ryanjhermes/Wearable/enclosure/generated/mechanical_review/pcb_front.png

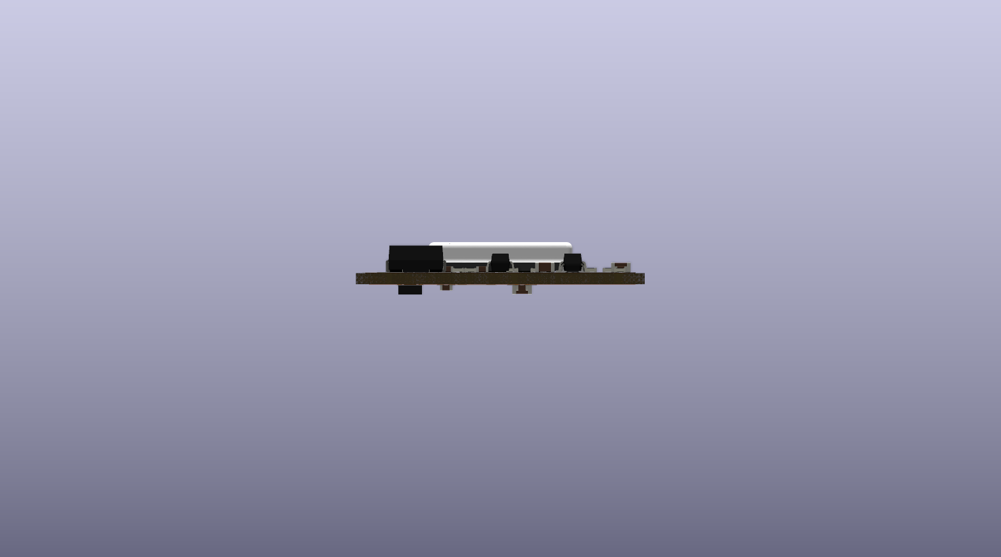
enclosure/generated/mechanical_review/pcb_front.png
