ryanjhermes/Wearable/enclosure/generated/mechanical_review/pcb_bottom.png

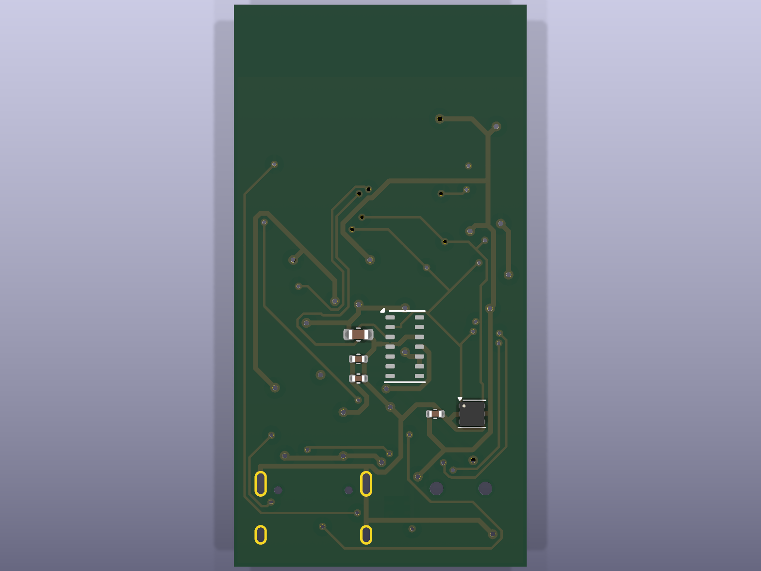
enclosure/generated/mechanical_review/pcb_bottom.png
