ryanjhermes/Wearable/enclosure/generated/mechanical_review/enclosure_bottom_isometric.png

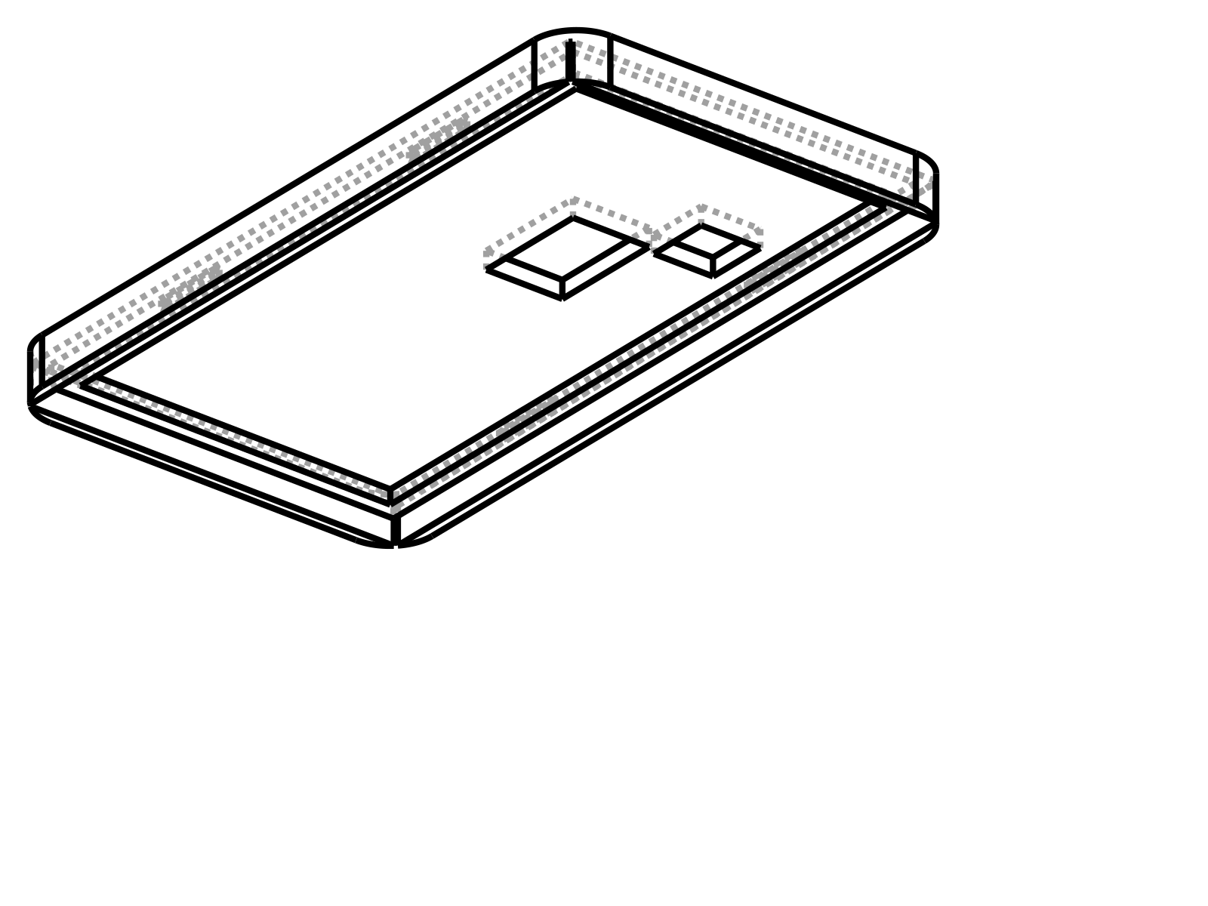
enclosure/generated/mechanical_review/enclosure_bottom_isometric.png
