ryanjhermes/Wearable/enclosure/generated/mechanical_review/enclosure_top_isometric.png

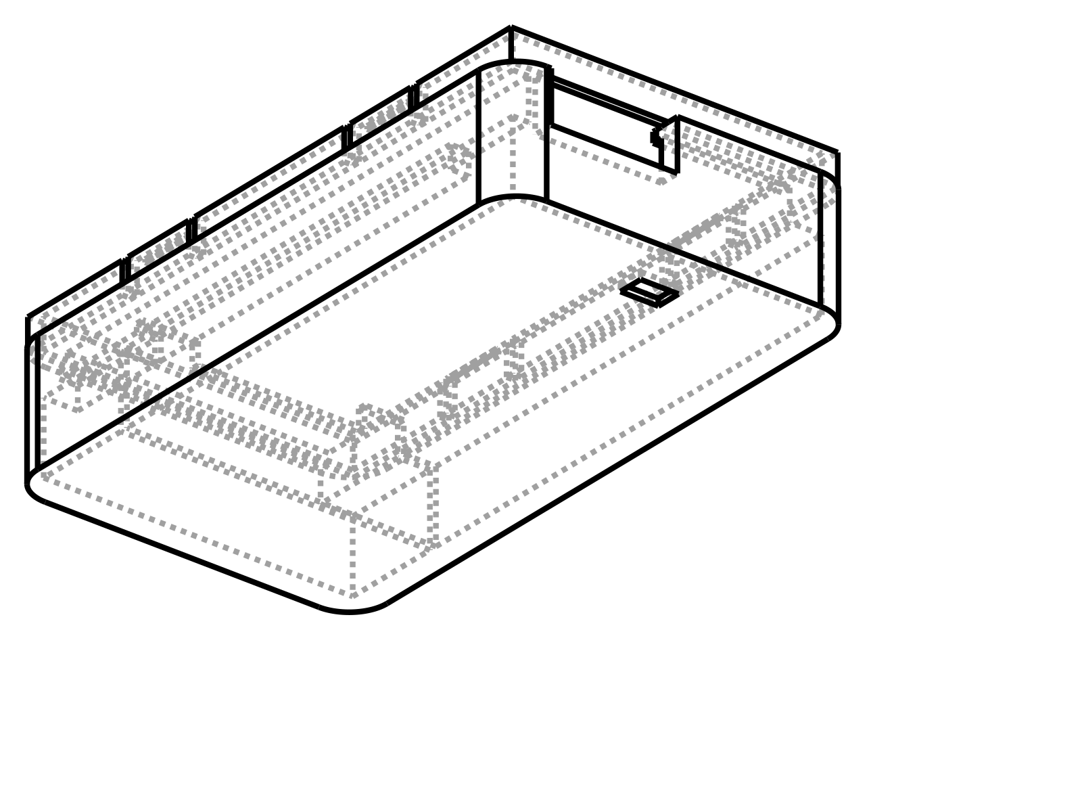
enclosure/generated/mechanical_review/enclosure_top_isometric.png
