ryanjhermes/Wearable/enclosure/generated/mechanical_review/pcb_top.png

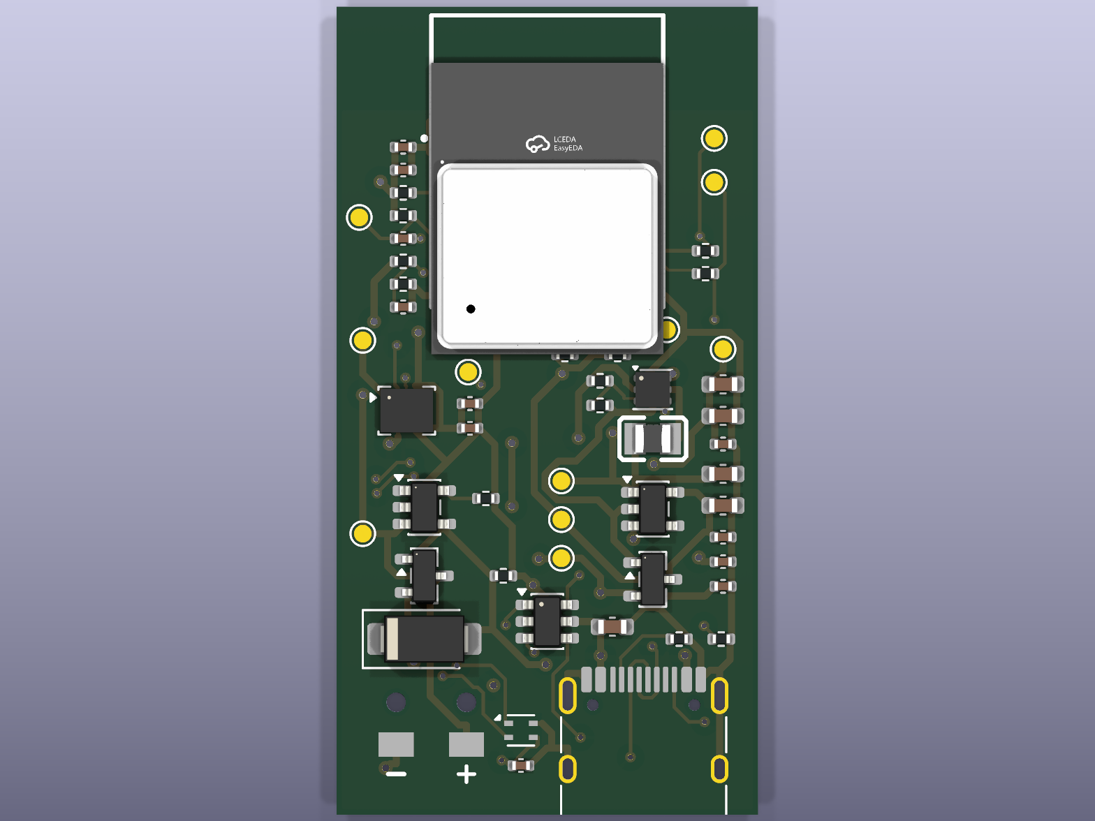
enclosure/generated/mechanical_review/pcb_top.png
