ryanjhermes/Wearable/enclosure/images/enclosure_interior.png

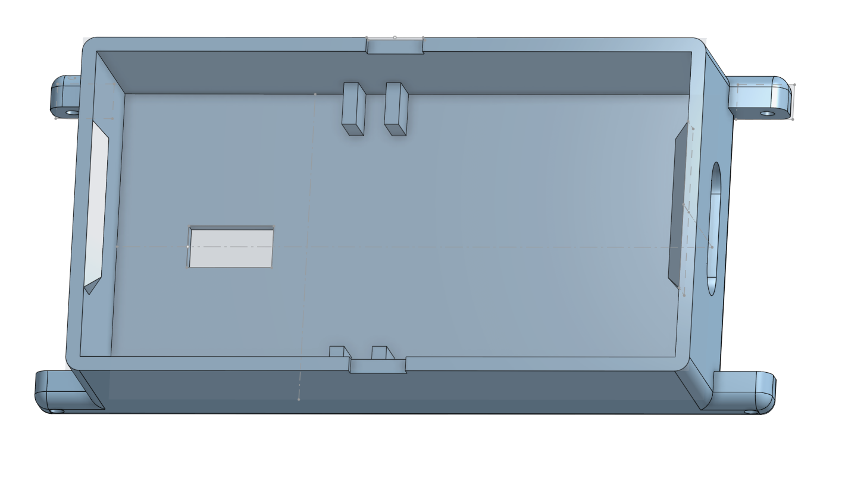
enclosure/images/enclosure_interior.png
