ryanjhermes/Wearable/parts/_reference/README.md

# Reference documents

Cross-cutting design documents, stored locally for future schematic agents.

| File | What it's for |
|---|---|
| `esp32-c3_hardware_design_guidelines_en.pdf` | **The key doc for schematic + layout** — power sequencing, strapping pins, antenna keepout rules |
| `esp32-c3-devkitm-1_reference_schematic.pdf` | Known-good USB / power / boot circuitry to copy |
| `esp32-c3_chip_datasheet_en.pdf` | Chip-level detail behind the module |
| `microchip-an1149-load-sharing.pdf` | Microchip AN1149 revision C: minimal P-MOSF + Schottky USB/battery load sharing and why system load must be isolated from charger termination |
