ryanjhermes/Wearable/enclosure/generated/mechanical_review/mechanical_fit_assembly.step

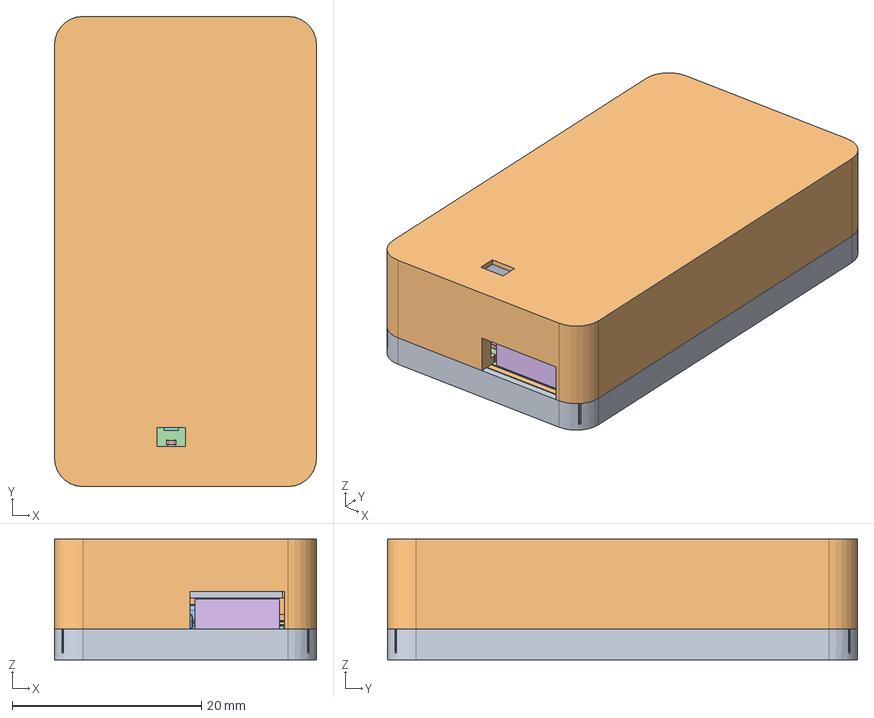
[picture p31: CAD file, 2026-09-18]
enclosure/generated/mechanical_review/mechanical_fit_assembly.step
27.7 x 49.7 x 12.8 mm
