ryanjhermes/Wearable/enclosure/enclosure_top.3mf

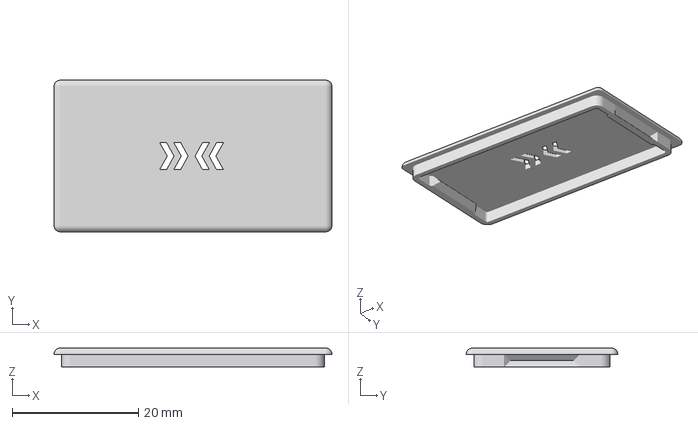
[picture p32: CAD file, 2026-07-24]
enclosure/enclosure_top.3mf
44.0 x 24.0 x 3.00 mm
