ryanjhermes/Wearable/enclosure/generated/mechanical_review/battery_wire_keepout.step

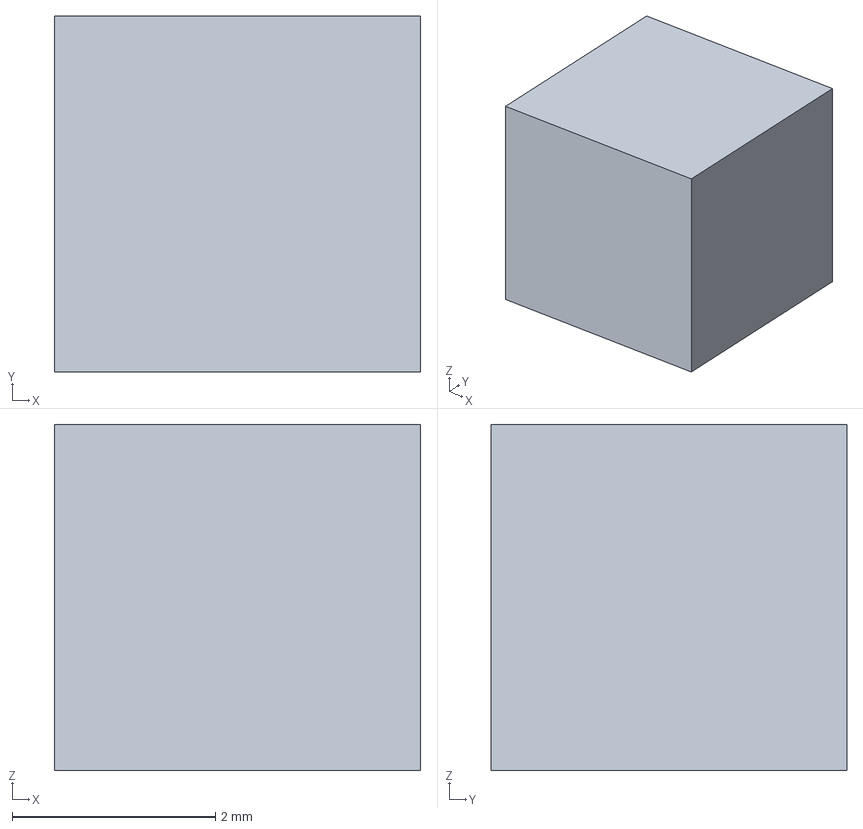
[picture p33: CAD file, 2026-09-18]
enclosure/generated/mechanical_review/battery_wire_keepout.step
3.60 x 3.50 x 3.40 mm
