ryanjhermes/Wearable/pcb/fabrication/jlcpcb_standard_pcba/assembly/wearable_v2_pcb.step

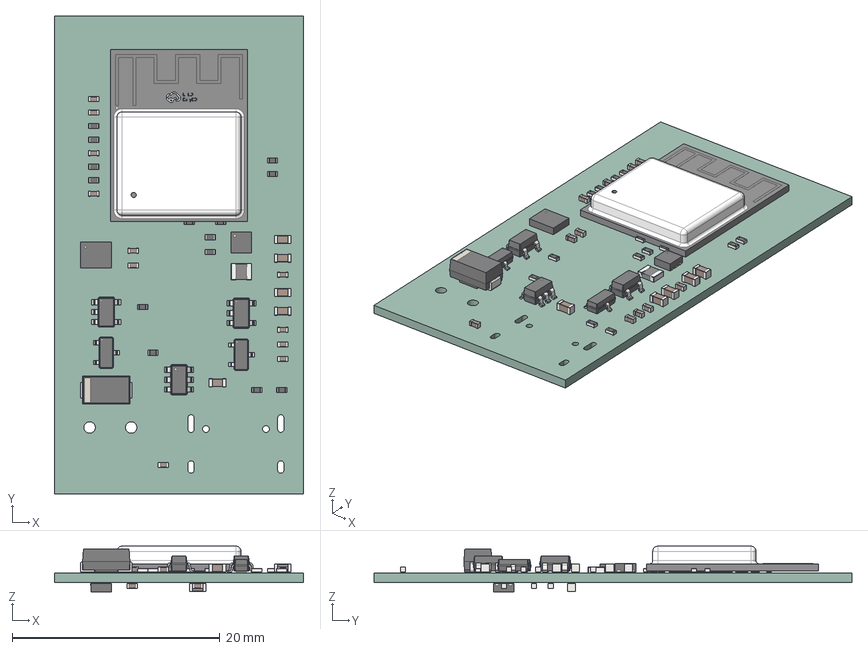
[picture p34: CAD file, 2026-09-18]
pcb/fabrication/jlcpcb_standard_pcba/assembly/wearable_v2_pcb.step
24.0 x 46.0 x 4.40 mm
R_0402_1005Metric x 17
C_0402_1005Metric x 14
LGA_14_3x25mm_P05mm_LayoutBorder3x4y
C_0603_1608Metric x 6
L0806_L2.0-W1.6-H1.0
SOT-23-5 x 2
SOT-23 x 2
SOT-23-6
WIFIM-SMD_ESP32-C3-MINI-1
WSON_6_1EP_2x2mm_P065mm_EP1x16mm x 2
D_SMA
wearable_v2_PCB
