ryanjhermes/Wearable/enclosure/enclosure_bottom.3mf

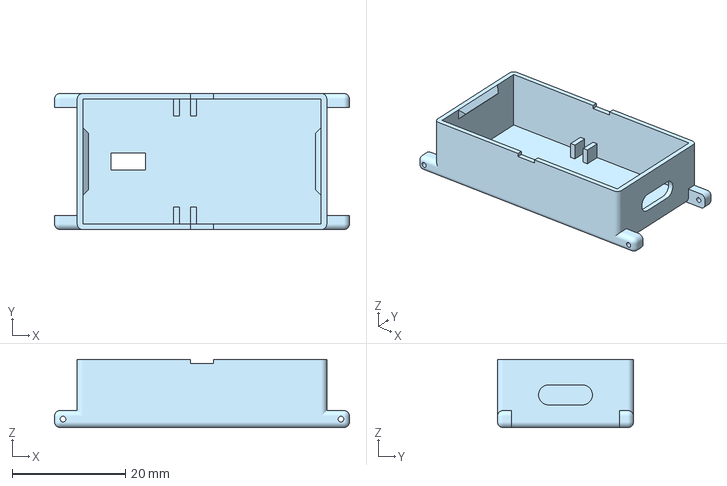
[picture p35: CAD file, 2026-07-24]
enclosure/enclosure_bottom.3mf
52.0 x 24.0 x 12.0 mm
