ryanjhermes/Wearable/enclosure/generated/mechanical_review/selected_battery_envelope.step

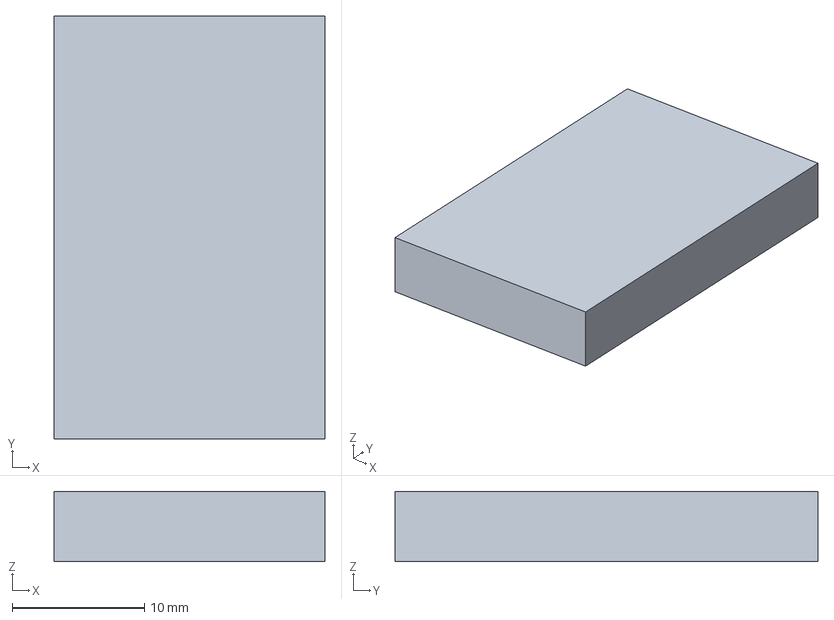
[picture p36: CAD file, 2026-09-18]
enclosure/generated/mechanical_review/selected_battery_envelope.step
20.5 x 32.0 x 5.30 mm
