ryanjhermes/Wearable/enclosure/generated/mechanical_review/enclosure_top.step

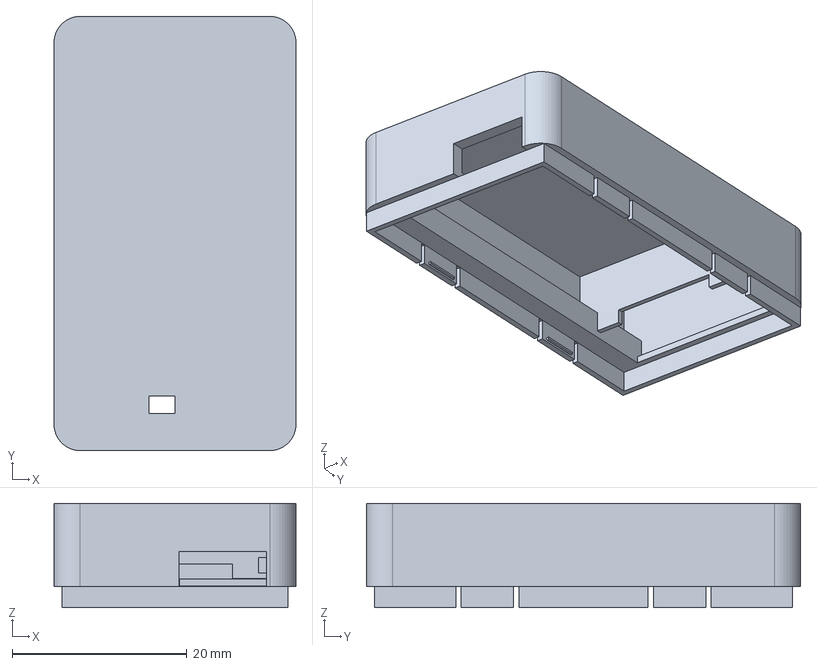
[picture p37: CAD file, 2026-09-18]
enclosure/generated/mechanical_review/enclosure_top.step
27.7 x 49.7 x 11.9 mm
