ryanjhermes/Wearable/enclosure/generated/mechanical_review/enclosure_bottom.step

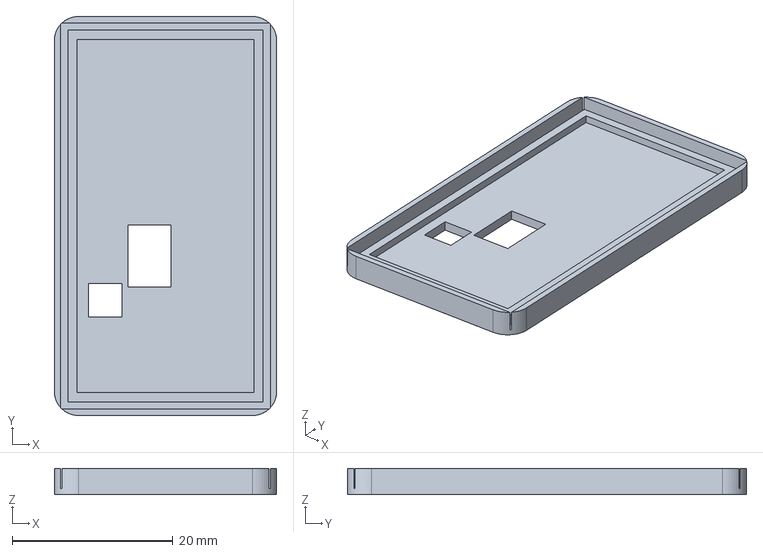
[picture p38: CAD file, 2026-09-18]
enclosure/generated/mechanical_review/enclosure_bottom.step
27.7 x 49.7 x 3.25 mm
