ryanjhermes/Wearable/enclosure/generated/mechanical_review/tmp117_thermal_pad.step

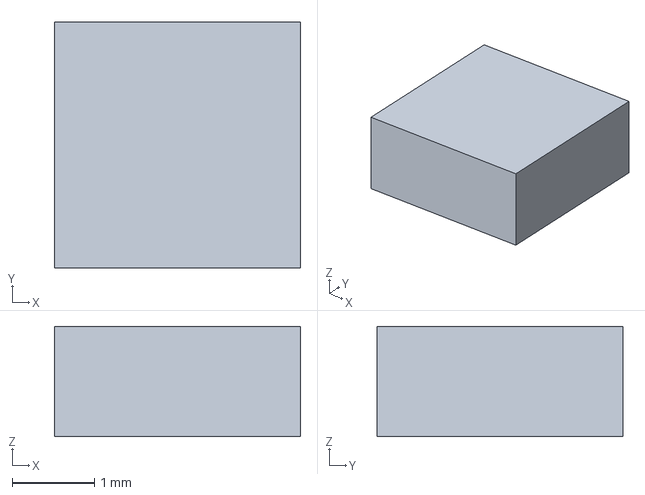
[picture p39: CAD file, 2026-09-18]
enclosure/generated/mechanical_review/tmp117_thermal_pad.step
3.00 x 3.00 x 1.34 mm
