ryanjhermes/Wearable/enclosure/generated/mechanical_review/wearable_v2_board_only.step

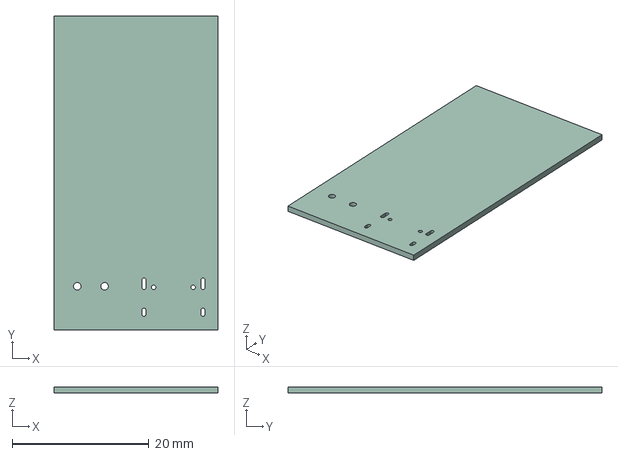
[picture p40: CAD file, 2026-09-18]
enclosure/generated/mechanical_review/wearable_v2_board_only.step
24.0 x 46.0 x 0.91 mm
