ryanjhermes/Wearable/enclosure/generated/mechanical_review/max30101_opaque_gasket.step

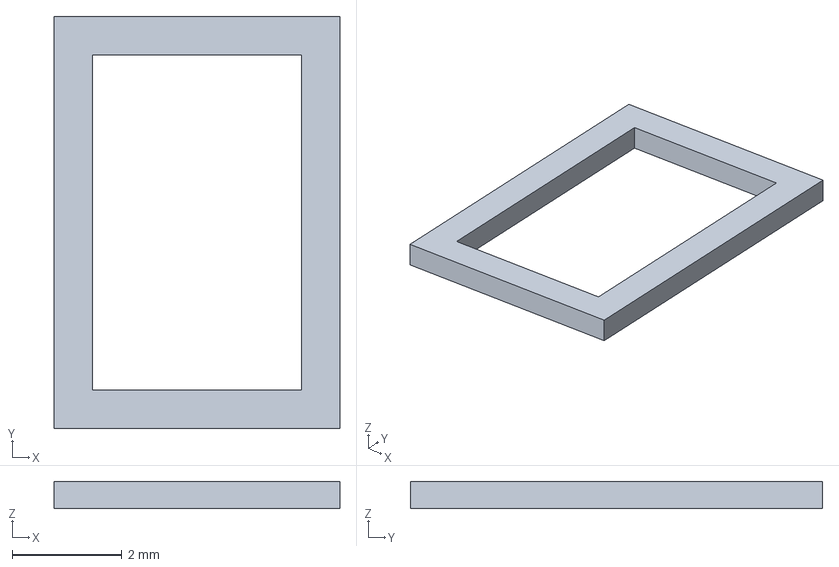
[picture p41: CAD file, 2026-09-18]
enclosure/generated/mechanical_review/max30101_opaque_gasket.step
5.20 x 7.50 x 0.5 mm
