ryanjhermes/Wearable/(list of files, cad)

Other CAD files:
enclosure/generated/mechanical_review/enclosure_bottom.stl
enclosure/generated/mechanical_review/enclosure_top.stl
