ryanjhermes/Wearable/enclosure/images/enclosure_assembled.png

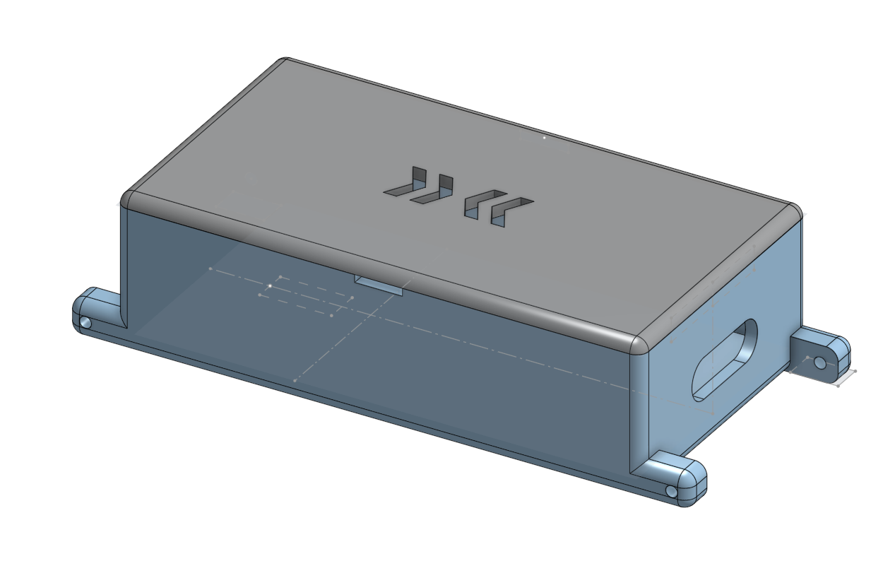
enclosure/images/enclosure_assembled.png
