ryanjhermes/Wearable/pcb/fabrication/jlcpcb_standard_pcba/assembly/gerber_view_bottom.png

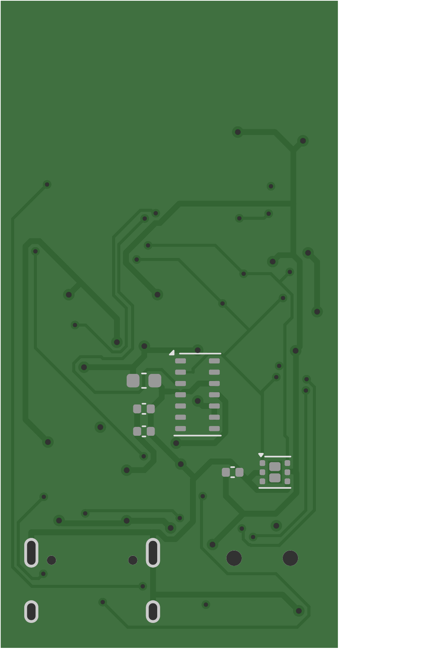
pcb/fabrication/jlcpcb_standard_pcba/assembly/gerber_view_bottom.png
