ryanjhermes/Wearable/pcb/fabrication/jlcpcb_standard_pcba/assembly/gerber_view_top.png

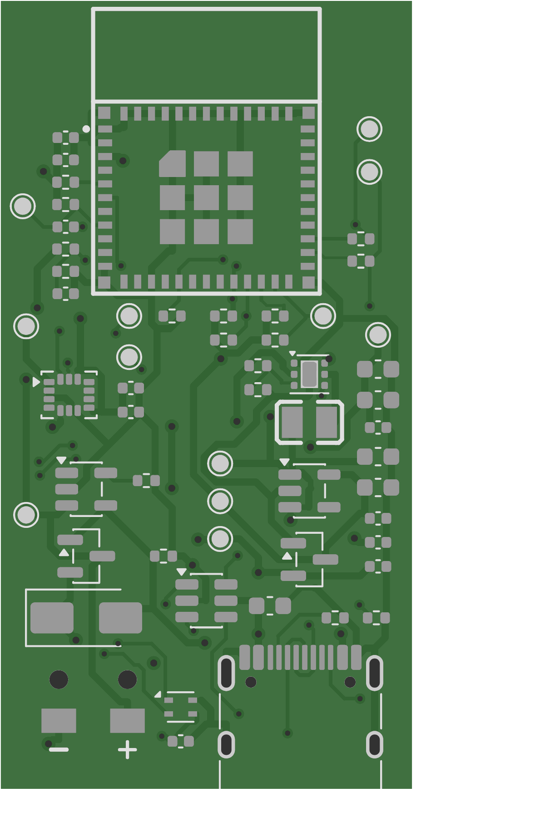
pcb/fabrication/jlcpcb_standard_pcba/assembly/gerber_view_top.png
