ryanjhermes/Wearable/business/competitors/BACtrack/Fairbairn-et-al-ACER-In-Press-Temporal-Dynamics-of-Transdermal-Alcohol-Concentration-Measured-via-New-Generation-Wrist-Worn-Biosensor.pdf

TIMING TRANSDERMAL ALCOHOL DETECTION | 1

Temporal Dynamics of Transdermal Alcohol Concentration Measured via New Generation

Wrist-Worn Biosensor

Catharine E. Fairbairn and Dahyeon Kang

University of Illinois at Urbana-Champaign

Catharine E. Fairbairn, Ph.D. and Dahyeon Kang, B.S., Department of Psychology,

University of Illinois—Urbana-Champaign.

This research was supported by NIH grant R01AA025969 to Catharine Fairbairn. Our

thanks to Brynne Velia and the students of the Alcohol Research Laboratory for their help in the

conduct of this research. Our thanks also to Robert Swift for helpful feedback on concepts

presented within this manuscript.

Correspondence concerning this article should be addressed to Catharine Fairbairn,

Ph.D., Department of Psychology, 603 East Daniel St., Champaign, IL 61820. Electronic mail:

cfairbai@illinois.edu.

In Press at Alcoholism: Clinical and Experimental Research

Abstract

Background: The development of a transdermal alcohol biosensor could represent a tremendous

advance towards curbing problematic drinking. But several factors limit the usefulness of extant

transdermal technology, including relatively lengthy delays between blood alcohol concentration

(BAC) and transdermal alcohol concentration (TAC), as well as the large/bulky designs of

currently available transdermal sensors (e.g., ankle monitors). The current research examined the

lag time between BAC and TAC using a prototype of BACtrack Skyn—a new-generation wrist-

worn transdermal sensor featuring a compact design and smartphone integration. Methods:

Participants (N=30) received either a dose of alcohol (target BAC .08%) or a non-alcoholic

beverage in the laboratory while wearing both the AMS SCRAM ankle monitor and a Skyn

prototype. Participants were monitored in the laboratory until breath alcohol concentration

(BrAC) dropped below .025%. Results: Device failure rates for Skyn prototypes were relatively

high (18%-38%) compared with non-prototype SCRAM devices (2%). Among participants with

usable data, both Skyn and SCRAM-measured TAC showed strong correlations with BrAC, and

both Skyn and SCRAM devices detected alcohol within 30-minutes of first alcohol-

administration. Skyn-measured TAC peaked over 1-hour earlier than SCRAM-measured TAC

(54 versus 120 minutes after peak BrAC, respectively), and time-series models suggested that, on

average across all measured portions of the BrAC curve, Skyn-TAC lagged behind BrAC by 24

minutes, whereas SCRAM-TAC lagged behind BrAC by 69 minutes—all differences statistically

significant at p<.001. Conclusions: Results provide preliminary evidence for the validity of a

new-generation wrist-worn transdermal sensor under controlled laboratory conditions, and

further suggest favorable properties of this sensor as they pertain to the latency of transdermal

51 | alcohol detection. The prototype-version of Skyn employed here displayed a higher failure rate
52 | compared with SCRAM and, in future, more reliable and robust Skyn prototypes will be required
53 | suitable to field testing across diverse environmental conditions.
54 | Keywords: Alcohol, biosensor, transdermal, BAC, measurement

55

56

57

58

The development of a wearable alcohol biosensor could represent a key advance toward

helping people make informed decisions about their drinking and, potentially, toward curbing

alcohol-related morbidity and mortality. Devices for the objective quantification of behaviors

have long been of interest to researchers and consumers across health domains (e.g., fitbit for

exercise; Haynes & Yoshioka, 2007), but, due to alcohol’s neurocognitive effects and also

cultural conventions surrounding drinking, the need for a biosensor to measure alcohol

consumption has loomed particularly large. Specifically, drinking at more extreme levels is

associated with memory and cognitive disruptions that can impair awareness of the quantity of

alcohol consumed (Weissenborn & Duka, 2003; White, 2003). Further, standard drink sizes and

quantities can vary widely so that even the cognitively alert drinker may not always be aware of

the amount of alcohol she ingests (Barnett, Wei, & Czachowski, 2009; Kerr, Greenfield,

Tujague, & Brown, 2005; Kerr, Patterson, Koenen, & Greenfield, 2008). Finally, societal stigma

can accompany alcohol consumption for many individuals such that, even given an awareness of

their own drinking practices, some might be reluctant to share this information with others, thus

interfering with the identification of those in need of alcohol intervention as well as the

investigation of drinking behavior via research (Davis, Thake, & Vilhena, 2010; George,

Gournic, & McAfee, 1988; Zapolski, Pedersen, McCarthy, & Smith, 2014). A wearable alcohol

biosensor might serve health needs across a variety of domains, including aiding prevention of

alcohol-related disorders (Fairbairn & Kang, in press), improving outcomes in harm reduction

alcohol intervention programs (Barnett, 2015), reducing the number of alcohol-related motor

vehicle fatalities (Blincoe, Miller, Zaloshnja, & Lawrence, 2015), and refining outcome

assessment in alcohol research (Leffingwell et al., 2013).

Researchers have explored a variety of different methods for the continuous tracking of

drinking (Fairbairn & Kang, in press; Swift, 2003), but transdermal devices are currently those

with the firmest basis of empirical support for their viability as continuous alcohol biosensors.

Approximately 1% of alcohol consumed is diffused transdermally in the form of sweat and

insensible perspiration (Swift, 2003; Swift & Swette, 1992). Thus, similar to the manner in

which a breathalyzer estimates BAC by measuring the quantity of alcohol in expired air,

transdermal sensors might estimate BAC by examining alcohol in water vapor emitted from the

skin. Measured via a device that rests on the surface of the skin, transdermal assessment is

passive and unobtrusive. Correlations between transdermal alcohol concentration (TAC) and

blood alcohol concentration (BAC) tend to be strong (Giles et al., 1987; Luczak & Rosen, 2014;

Sakai, Mikulich-Gilbertson, Long, & Crowley, 2006). Yet, despite their promise, challenges

have emerged for transdermal monitors—including challenges associated with the available

devices themselves as well as those associated the data produced by these devices—and these

challenges have limited the widespread implementation of transdermal alcohol assessment within

research and also everyday drinking contexts.

Concerning challenges associated with the devices themselves, at the present time, the

only available transdermal monitors take the form of relatively large/bulky bracelets designed to

be worn around the ankle. Although previously some smaller wrist-worn transdermal devices

were accessible to researchers (e.g., the WrisTAS device)¹
, at the current time, the Secure

Continuous Remote Alcohol Monitor (SCRAM) ankle bracelet is the only widely-available

wearable alcohol biosensor. SCRAM devices, which weigh about 6 oz and are approximately the

1 One of the first transdermal devices developed was the WrisTAS, marketed by Giner Labs, which was worn around the wrist as a watch (Leffingwell et al., 2013). However, this device was only used for research purposes, to our knowledge, and has not been made available to researchers for several years now.

dimensions of a large deck of cards, are mainly designed as abstinence monitors for use with

criminal justice-involved populations (see Figure 1). Data from SCRAM has been examined in

several dozen studies (Fairbairn et al., 2018; Sirlanci et al., 2018; see Leffingwell et al., 2013 for

a review), and associations between SCRAM-measured TAC and BAC have been generally

estimated as strong. SCRAM employs fuel cell technology whereby alcohol molecules are

translated into a measurable electrical current at the sensor. The large size of these bracelets is

partially attributable to the nature of the specific fuel cell employed, which requires a pump to

promote the active flow of air across the sensor, a feature that also limits the TAC sampling

interval to a relatively extended 30 minutes (Wang, Fridberg, Leeman, Cook, & Porges, in

press). The size, ankle positioning, and relatively sparse data produced by these devices appear

to be well suited for their application as abstinence monitors with non-voluntary populations.

However, since wearing SCRAM devices can produce discomfort and embarrassment (Barnett,

Tidey, Murphy, Swift, & Colby, 2011), the usefulness of these ankle monitors for voluntary

populations (e.g., as health behavior trackers among large populations of consumers) is severely

limited.

In addition to challenges associated with the transdermal devices themselves, another

important challenge surrounds the nature of the data produced by these devices—in particular,

delays between the time that alcohol is ingested and when it can be detected transdermally. TAC

is believed to lag behind BAC by a substantial margin, with the extent of this lag being typically

estimated as lasting at least 1-hour (Fairbairn & Kang, in press; Leffingwell et al., 2013), and

potentially as long as 3-4 hours (Marques & McKnight, 2009). Note that several of the more

pressing proposed applications of transdermal alcohol biosensors would require real-time or near

real-time estimation of drinking (Fairbairn et al., 2018; Fairbairn & Kang, in press)—e.g., researchers aiming to map everyday alcohol use with associated antecedent and/or consequent

behaviors in real time. Of note, while it is clear that some delay exists between BAC and TAC,

the exact extent of this delay is currently unclear. In estimating this delay, researchers have

mainly employed SCRAM ankle monitors, and have further examined delays nearly exclusively

by examining the relative timing of TAC/BAC peaks (Sakai et al., 2006; Swift, Martin, Swette,

Laconti, & Kackley, 1992). Regarding the former of these issues, since the permeability of the

skin and also the density of sweat glands differs on different areas of the body, the relationship

between BAC and TAC also differs depending on where on the body TAC is assessed (Swift,

2000). Indeed, a review of the literature indicates that the notion that TAC lags behind BAC by a

factor of 2-4 hours is derived entirely from studies employing ankle monitors (Fairbairn, Rosen,

Luczak, & Venerable, in press; Marques & McKnight, 2009), whereas studies employing wrist

sensors (e.g., the early WrisTAS device) have estimated substantially smaller lag times (Swift et

al., 1992; see Table 1 for a literature review of studies examining TAC in relation to objectively

assessed BAC). In addition, a more nuanced operationalization of lag-time—encompassing

other portions of the BAC curve beyond TAC/BAC peak—could aid in informing our

understanding of the relative timing of TAC vs. BAC.

Recently, a new generation of wrist-worn devices has emerged that leverages advances in

electronics and wireless communication in order to substantially reduce the size and increase the

comfort/attractiveness of transdermal alcohol monitors (Wang et al., in press). One such device

is BACtrack Skyn™. Skyn is a small device that includes a transdermal alcohol biosensor,

rechargeable battery, and a companion smartphone application. Skyn is worn on the inside of the

wrist—a position selected to increase its sensitivity and decrease lag to detected alcohol.

Currently in the prototype phase, Skyn is designed to be comfortable, user friendly, and socially acceptable, similar to a Fitbit or smartwatch (see Figure 1). Like SCRAM, Skyn uses fuel cell

technology in order to assess TAC. Unlike SCRAM, however, Skyn devices do not require a

pump to generate air flow across the sensor and instead rely on passive airflow—a feature that

reduces the size and dimensions of the device and also facilitates more rapid TAC sampling, with

current prototypes allowing for sampling as frequently as every 20 seconds (Wang et al., in

press). While the new generation of transdermal alcohol sensors hold promise for use in research

as well as for widespread health behavior monitoring, these devices have not been examined in

controlled studies and so the relation of readings produced by these devices to ingested alcohol is

unknown.

In the current study, we employ laboratory methods to directly compare data produced by

two transdermal alcohol monitors—the widely-researched SCRAM ankle monitor and the newer

wrist-worn Skyn device. This study focuses on an examination of TAC over time among

participants administered a single fixed dose of alcohol, although we also include a subsample of

participants administered no alcohol by way of control. We used breathalyzer readings to

validate TAC measures—chosen as a noninvasive measure with a strong and well characterized

relationship with BAC (Bendtsen, Hultberg, Carlsson, & Jones, 1999; Jones & Andersson, 1996,

2003; Ramchandani, Plawecki, Li, & O’Connor, 2009). In light of the identified challenges

surrounding delays in the detection of alcohol via transdermal monitors (Leffingwell et al.,

2013), the primary aim of this research is to examine and quantify lag times between ingested

alcohol and TAC, operationalized through a range of metrics intended to capture various

positions on the BAC curve.

Note that the restricted alcohol dosing procedures employed in this study are well-suited

to addressing our primary aim of examining comparative lag times across transdermal sensors under controlled conditions, whereas the limited variation in BAC produced by these procedures

mean that they are less well suited to quantifying the magnitude of BAC-TAC correlations.

Nonetheless, given that no prior study has quantified BAC-TAC correlations using this newest

generation of transdermal sensors, we also include a preliminary examination of BAC-TAC

correlations for both Skyn and SCRAM as a supplemental analysis.

Method

Participants

A total of 50 young social drinkers underwent experimental procedures. The final sample

of participants consisted of the 30 individuals for whom we were able to obtain breathalyzer,

SCRAM, and also Skyn readings for the experimental session (see later section on device

failures). This final sample of participants consisted of 25 participants assigned to the alcohol

condition and 5 participants assigned to the control condition. The average age of participants

was 22 years old (range, 21-28). Participants were 50% female (15 females and 15 males). Sixty

percent of participants identified as White, 23.3% as Asian, and 16.6% as multiracial (3.3%

African-American/Hispanic, 3.3% Hispanic/Asian, 3.3% White/Asian, 6.7% White/Hispanic).

Participants were required to be at least 21 years of age and no older than 30, to consume alcohol

regularly, and report being comfortable with the dose of alcohol administered in the study.

Exclusions included taking medications that might interact with alcohol, medical conditions for

which alcohol consumption was contraindicated, pregnancy in women, history of severe Alcohol

Use Disorder, or especially light drinking practices (see recommendations of the National

Advisory Council on Alcohol Abuse and Alcoholism, 1989 for alcohol-administration in human

subjects). On average, participants reported drinking alcohol on 10.13 days out of the past 30

(SD=4.73) and consuming an average of 4.90 drinks per occasion (SD=1.83).

Procedure

Participants who successfully completed a phone screening were invited into the

laboratory for a beverage-administration session. All participants were required to abstain from

drinking alcohol for at least 12 hours prior to their laboratory session, and to refrain from eating

for 4 hours. Upon arriving in the laboratory, participants were breathalyzed (Intoximeters Alco-

Sensor IV) to ensure a 0.00 breath alcohol concentration (BrAC), and their weight and height

was assessed. Pregnancy was assessed in female participants via HCG urine test strip.

Participants were then given a light meal that was roughly adjusted for their weight.

Next, SCRAM monitors were positioned on the inside of participants’ left ankles, worn

high up on the leg, snug against the calf. Skyn devices were positioned on the inside of

participants’ left wrists. Both devices were then worn for a no-alcohol baseline period

(approximately 1 hour), during which baseline TAC readings were established and participants

completed questionnaires unrelated to the current study.

Participants were next administered their study beverages. Beverages were administered

in 3 equal parts over the course of 36 minutes, and participants were encouraged to consume

their beverages evenly over each of the three 12-minute intervals. Participants assigned to

receive alcohol received a dose intended to bring them up to the legal driving limit (.08%). The

precise amount of alcohol administered was adjusted for each individual’s body water as

calculated based on formulas accounting for gender, height, age, and weight (Curtin & Fairchild,

2003; Watson, Watson, & Batt, 1981). Note that this dose of alcohol was originally chosen for

the purposes of the parent study investigating alcohol’s effects on mood (e.g., Fairbairn et al.,

2018, 2015), but it also has utility for the proposed project, given potential applications of

wearable biosensors for determining driving safety. Control participants received an isovolumic amount of a non-alcoholic beverage. Assignment to beverage condition was randomly

determined. Beverage intake was monitored via video to validate drink start time (see below) and

also to ensure even consumption across the 36-minute drink period.

Following beverage administration, participants in the alcohol condition provided

breathalyzer readings at approximately 30-minute intervals until they left the lab. During this

time period, participants engaged in a variety of study tasks, ranging from those requiring a

moderate amount of walking (e.g., between rooms in a lab) as well as those that were largely

stationary (e.g., speaking with another participant while seated). Participants in the control

condition were allowed to leave after study tasks were completed (3-4 hours after the end of

drinking). Participants administered alcohol were required to stay in the lab until their BrAC

dropped below .025%²
and also their SCRAM TAC output registered at least one descending

value (generally between 5-7 hours post-drink—average BrAC among alcohol participants at

discharge .019%).

Data Processing and Analysis

Skyn data was transmitted via Bluetooth from Skyn devices to BACtrack’s custom

smartphone application, which was installed on our lab’s ipod touch devices. The application

displays TAC readings in graphical form, and the raw data files can be exported in the form of

csv files via this application or BACtrack’s internet-based data storage system. SCRAM data was

extracted using direct connect software and downloaded from SCRAMnet, a cloud-based server.

We analyzed latency of TAC values relative to the onset of drinking and BrAC curves

using the following three metrics: 1) latency to first transdermally detected alcohol; 2) time

In the current study, given the relatively substantial dose of alcohol administered, it was not feasible to keep participants in the lab until their BAC reached 0.00. Note that, including the pre-drink baseline, visits often lasted as long as 9 hours. Using the current procedures, we were able to capture the majority of the descending limb of the BAC curve.

elapsed between peak BrAC and peak TAC; and 3) latency to maximal cross-correlation across

TAC and BrAC curves. As an examination of these latency metrics among control participants

would not have been meaningful and, in some cases, would have been impossible (e.g., latency

to peak BrAC where BrAC values consist of all 0s), only participants assigned to the alcohol

condition were included in latency analyses. Note that data produced by SCRAM is standardized

such that it includes a natural zero starting value. In contrast, data produced by the Skyn

prototypes used in this study featured no standardized zero point, with baseline values varying

across Skyn files. With respect to time to first transdermally detected alcohol, for SCRAM TAC,

this was operationalized as the time elapsed from the very beginning of the participant drink

period to time of first non-zero SCRAM reading.

3
For Skyn TAC (files with no natural zero

point—see above), latency to first transdermally detected alcohol was operationalized via a

function that systematically tests each point in a series and automatically detects points of change

in the trend using a formula that minimizes the sum of the residual error and applies a penalty for

each change (MATLAB changepoint function; Killick, Fearnhead, & Eckley, 2012). Finally,

with respect to cross-correlations, these analyses were conducted at the level of the participant

and specifically targeted those assigned to receive alcohol (see below). In particular, cross-

correlation coefficients indexed the correlation between an individual’s BrAC with that

individual’s TAC (either Skyn or SCRAM) at various lag times (or latencies) over the course of

the session.⁴
Since the sampling intervals for BrAC and SCRAM TAC were relatively sparse

3 Note Alcohol Monitoring Systems (AMS) itself uses a much higher threshold (at least .02% TAC) when processing SCRAM data files in order to identify alcohol episodes. This relatively high TAC threshold is adopted in order to reduce the risk for false positives, which were not a concern in the current study.
4 Cross-correlation is a metric for assessing the similarity of two time series as a function of the level of displacement between the series. A cross-correlation analysis will produce the value of the correlation of two time series across multiple different “lags” or displacement levels—e.g., Skyn value at time t with BrAC at t-1, Skyn value at time t with BrAC at t+1, contemporaneous Skyn and BrAC, etc. The maximal cross-correlation—or the time lag at which the correlation between the two time series is at its peak—can be used to assess the level of displacement between the two time series.

(~30 minutes) when compared with Skyn (1 minute), BrAC and SCRAM data was interpolated

from sampled values such that a file with minute-level estimates of BrAC, SCRAM TAC, and

Skyn TAC was produced for each participant spanning the time period from the beginning of the

drink period to last BrAC reading (Fritsch & Carlson, 1980; Sidek & Khalil, 2013). Cross-

correlation analysis was applied to each participant file and the lag time that maximized the

value of the cross-correlation function between BrAC and TAC (both Skyn and SCRAM) was

recorded for each participant (Gottman, 1981). Paired t-tests were used to compare lag times for

Skyn TAC and SCRAM TAC.

The association between BrAC and transdermally detected alcohol was assessed using

the following three metrics: 1) Correlation in peak BrAC and TAC values across participants; 2)

Correlation in area under the curve for BrAC and TAC across participants; 3) Maximal value of

cross-correlation between BrAC and TAC for each participant. For the purposes of calculating

peak and area under the curve values, Skyn data was centered and standardized by subtracting

the start value (reading taken at the initiation of the drink period) from all subsequent readings.

All participants (alcohol and control) were included in the analysis of peak values and area under

the curve—which examine variation between participants—whereas only participants in the

alcohol condition were included in cross-correlation analyses—which examine variation within

participants over time, and so variability at the within-subject level is required. Area under the

curve for BrAC, Skyn, and SCRAM data was calculated by summing all data points from the

beginning of the drink period to the last moment that a BrAC reading was taken. Pearson

correlation coefficients were used to examine associations between peak values and area under

the curve for BrAC and TAC. Maximum cross-correlations between BrAC data and TAC (see above) were calculated for each participant and then Skyn and SCRAM correlations for each

participant were compared using paired t-tests.

Results

Descriptive and Device Statistics: Among those assigned to receive alcohol, average peak

BrAC was .08% (SD=.01; Range .06-.12). Five different Skyn prototype devices and 13 SCRAM

ankle monitors were used for this research. The five Skyn devices employed included 3 older

generation prototype devices (manufactured in 2016) and 2 newer generation prototype devices

with improved Bluetooth connectivity and other additional features (manufactured in 2018).

Among alcohol participants, over the course of the entire lab session, the average number of

BrAC readings collected per participant was 11 (SD=1.6), the average number of SCRAM TAC

readings was also 11 (SD=1.4), and the average number of Skyn TAC readings was 309

(SD=44.3).

In Figure 2, we provide visualizations of data from all alcohol (P1-P25) and control

participants (P26-30) during the laboratory session. In line with data produced in prior studies,

visual inspection of these data suggests that there exists variability in both Skyn and SCRAM

measured TAC that appears to be unconnected with alcohol consumption. Nonetheless, among

participants assigned to receive alcohol, TAC broadly mirrors the characteristic BAC curve,

ascending with alcohol ingestion and then descending with the passage of time following

ingestion.

Device Failure Rate: Note that Skyn devices used in this study were prototypes, and rates

of failure of both the devices and the accompanying smartphone application were relatively high.

A total of 9 Skyn files were either incomplete, blank, or unusable due to device failure (3 files

were completely blank for unknown reasons, 3 files consisted of an entirely flat line with no oscillation, and 3 files were blank or severely truncated due to battery failure). An additional 10

Skyn files were lost during the initial stages of this project as our team learned to work with

these delicate prototypes.⁵
In contrast, SCRAM devices, which are not in the prototype phase,

produced only one unusable (flat line) file within the conduct of this research. In sum, failure

rates for Skyn prototypes ranged from 18%-38% (depending on metric), whereas the failure rate

for SCRAM was 2%. Data presented below reflects that derived from our final sample of

participants—individuals for whom we were able to obtain BrAC, SCRAM, and also Skyn data

(see methods section).

TAC Latency: With respect to latency to first detected alcohol, both Skyn TAC and

SCRAM TAC appeared to perform relatively well, detecting alcohol within 30 minutes of the

initiation of the drink period. Time to first detected alcohol via Skyn was 22.08 (SD=12.38)

minutes⁶
and was very similar for SCRAM at 22.52 (SD=13.03) minutes. The difference between

these values was non-significant, t(24)=.14, p=.891. See also Table 2.

BrAC readings reached their peak an average of 77.28 (SD=30.34) minutes after the start

of drinking. Skyn TAC readings peaked an average of 131.52 (SD=32.90) minutes after the start

of drinking (54 minutes after peak BrAC), and SCRAM TAC readings peaked an average of

197.20 (SD=42.60) minutes after the start of drinking (120 minutes after peak BrAC). The

5 The Bluetooth connection feature of the Skyn devices naturally disconnected from the accompanying smartphone application throughout the visit as participants moved from room to room. In order to reconnect and generate a datafile for some of these Skyn prototypes, it was necessary to first close and then re-open the accompanying smartphone application and also disconnect/reconnect the device from Bluetooth—a quirk we discovered only with trial and error after experiencing some data loss.
In addition to the MATLAB changepoint function, we also attempted this analysis using one additional operationalization—defining time to first detected alcohol as 10 consecutive Skyn readings above the initial baseline value. Using this alternative operationalization, the average time to first detected alcohol via Skyn was 17.72 minutes (SD=11.51). However, given that the choice of “10 values” was somewhat arbitrary, we present the automated MATLAB approach (above) for the purposes of final analyses.

difference in lag time between peak Skyn TAC and peak SCRAM TAC emerged as highly

significant: Mdiff=65.68 minutes (SD=51.27), t(24)=6.41, p<.001.

Finally, when cross-correlation coefficients were examined, the average latency of

maximal cross-correlation between BrAC and Skyn TAC was 23.88 (SD=26.11) minutes. The

average latency of maximal cross-correlation between BrAC and SCRAM TAC was 68.56

(SD=36.83) minutes. The difference in lag time between peak Skyn TAC and peak SCRAM

TAC emerged as highly significant: Mdiff=44.68 minutes (SD=43.09), t(24)=5.18, p<.001. Note

that these values reflect the average lag time across all portions of the BAC curve measured in

the current research—representing the majority, although not the entirety, of BAC/TAC curves

(see methods). See Table 3 for cross-correlation lag times presented at the level of the device.

TAC-BrAC Associations: Here we provide preliminary information concerning the

association between BrAC, Skyn TAC and SCRAM TAC when dosing range in the alcohol

condition is highly restricted (see above). Across all 30 participants, there was a strong and

significant positive correlation between peak BrAC and peak Skyn TAC values, r=.77, n=30,

p<.001. There was also a strong significant correlation between peak BrAC and peak SCRAM

TAC, r=.56, n=30, p=.001. Participants who reached a higher peak BrAC also had higher peak

TAC values, as measured using Skyn and also SCRAM. Concerning area under the curve, there

was a strong and significant positive correlation for BrAC and Skyn TAC, r=.79, n=30, p<.001,

as well as for BrAC and SCRAM TAC, r=.60, n=30, p<.001. Finally, in cross-correlation

analyses examining within-participant change over time among alcohol participants examined as

time series (see above), the average maximal cross-correlation between BrAC and Skyn TAC

was .60 (SD=.15). The average maximal cross-correlation between BrAC and SCRAM TAC was

.51 (SD=.12). The difference between these correlations emerged as statistically significant:

Mdiff=.09 (SD=.20), t(24)=2.38, p=.026, with cross-correlations being higher for Skyn vs.

SCRAM. Note that results of analyses examining area under the curve and also cross-

correlations (although not peak values) should be interpreted with incomplete TAC/BAC

trajectories and also differential lag times for Skyn vs. SCRAM in mind. See Table 3 for cross-

correlations at the level of the device.

Discussion

Transdermal alcohol sensors represent a promising method for continuous, unobtrusive

measurement of alcohol consumption. But the measurement of alcohol consumption

transdermally has been associated with significant challenges, including those associated with

devices themselves as well as the delay in data produced by these devices. The current research

represents the first systematic examination of data produced via a new generation transdermal

device that features a compact, wrist-worn design, relatively rapid TAC sampling, and

smartphone connectivity. Specifically, using data derived from a controlled dosing context and

varied metrics for capturing TAC latency, we examined lag times between ingested alcohol and

transdermally detected alcohol among participants wearing both the SCRAM ankle monitor and

a prototype of the newer wrist-worn Skyn device. Both Skyn and SCRAM showed initial

temporal sensitivity to ingestion of a moderate dose of alcohol, detecting alcohol within 30

minutes of first consumption. As time progressed across the drinking episode, the wrist-worn

Skyn device emerged as generally faster in its response to alcohol ingestion compared with the

ankle-worn SCRAM. Specifically, TAC measured using Skyn reached its peak over an hour

prior to TAC measured using SCRAM (54 minutes after peak BrAC for Skyn vs. 120 minutes

after peak BrAC for SCRAM). On average, when all measured portions of the BAC curve were

considered via time-series models, Skyn lagged behind BrAC by approximately 24 minutes, whereas the average lag between BAC and SCRAM was significantly longer at 69 minutes. In

other words, in time-series models, the lag time between Skyn and SCRAM emerged as nearly

double the duration of lag time between Skyn and actual BrAC. Finally, this study also provides

some information on the validity of the wrist-worn prototype in terms of dose-response—

although associations captured within this study should be considered preliminary (likely

dampened) due to the restricted dosing range as well as the slightly truncated TAC/BAC

trajectories captured in our lab session. Note that Skyn devices used in this study were

prototypes, and data captured with both Skyn and SCRAM devices demonstrated variability in

TAC that appeared to be unrelated to BrAC. Nonetheless, correlations between Skyn TAC and

BrAC captured within this study were large in magnitude and tended to exceed correlations

between BrAC and SCRAM TAC.

The lag time between ingested alcohol and transdermally detected alcohol is typically

estimated as being at least 1 hour in duration (Leffingwell et al., 2013), with some studies

estimating this delay as lasting up to 4 hours (Marques & McKnight, 2009). Note that these

lengthier delay estimates have been derived from studies employing the SCRAM ankle monitor,

and have further not typically examined lag times at points on the BAC curve beyond peak

values (Marques & McKnight, 2009; Sakai et al., 2006; Fairbairn & Kang, in press; See Table 1

for a review). The prolonged nature of such delays might preclude certain real-world applications

of transdermal alcohol sensors—e.g., a drinker wishing to assess his/her safety for operating a

motor vehicle. As with past research, data from the current study continued to provide evidence

for a delay in the transdermal detection of alcohol when compared with BrAC. However, here,

when examined across the entire sampling interval investigated in this research—which

encompassed the majority (although not the entirety) of the BAC curve—the average lag time between Skyn-estimated TAC and BrAC was less than 30 minutes, significantly smaller than that

estimated via SCRAM. In the future, applications of advanced machine learning algorithms—

with the ability to predict future values based on sequences of current values—might ultimately

be applied to TAC data to further reduce the extent of this lag (Mandic & Chambers, 2001).

In addition to its implications for the understanding of lag times between BAC and TAC,

this research also contributes to the literature by providing preliminary information on the

validity of a relatively compact, wrist-worn sensor. To date, a barrier to the widespread

implementation of transdermal biosensors has been the relatively large/bulky nature of extant

transdermal devices. At the present time, the SCRAM ankle monitor is the only readily available

transdermal sensor. SCRAM, and similar devices, will likely continue to have an important place

in assessing drinking among criminal-justice involved populations and for some research and

clinical applications, and, at the current time, SCRAM remains the most reliable available

transdermal sensor. However, the relatively bulky design and ankle positioning of this device

limit its usefulness outside of specific clinical, criminal justice, and research applications and

preclude its implementation among broad populations of drinkers interested in tracking their

health behaviors. Thus, although approximately half of the world’s population drinks alcohol

(WHO, 2014), with 27% of US adults reporting at least one episode of binge drinking in the past

month (SAMHSA, 2015), only a subsample of these individuals are served by current

transdermal technology. Note that the current study examined TAC data in response to a fixed

dose of alcohol, restricting the range of BACs and so likely leading to attenuated estimates of the

associations between TAC and BAC. Nonetheless, despite the fixed dosing procedures,

associations between Skyn TAC and BAC emerged as strong. Thus, by providing initial data for

the validity of a compact, wrist-worn sensor, the current study takes an important first step towards providing an attractive, wearable device for everyday drinkers seeking to monitor their

alcohol consumption.

Although the current project represents an important first step to addressing specific

challenges associated with the transdermal detection of alcohol, many other key challenges lie

ahead before these devices are ready for real-world implementation. As noted above, similar to

data produced by prior studies (Leffingwell et al., 2013), data from the current study indicate that

the BAC-TAC correlation is strong, but yet this correlation is not a perfect one and so some

portion of the variation in TAC remains as yet unexplained. As it pertains to Skyn data, some of

this unexplained variability is likely attributable to the fact that the devices used in this study

were hand-assembled prototypes, and so this variability may diminish with device development

as prototypes improve and machine-made devices become available. It is also possible that some

of this unexplained variability may simply be a characteristic intrinsic to transdermal alcohol

measurement. Note that current Skyn prototypes collect data on not only TAC, but also include

temperature and accelerometer gauges—measures that may account for some portion of the

variability in the BAC-TAC relationship—and algorithms that incorporate information from all

of these gauges simultaneously may ultimately be able to provide a closer approximation of

exact BAC values. Further, the relationship between TAC and BAC is believed to vary

depending on both individual-level factors (e.g., the thickness of an individual’s skin) as well as

situation-level factors (e.g., degree of ambient humidity). Note that it is possible that the extent

of variation in the BAC-TAC relationship has been over-estimated due to a tendency of prior

studies to rely on data from the SCRAM monitor, the ankle positioning of which might lead to

increased variation in the distance between sensor and skin (e.g., sliding from sitting snug

against the calf to hanging loosely around the ankle bone as participants walk)—a factor that has been theorized to have an important impact on the BAC-TAC relationship (see Anderson &

Hlastala, 2006). Nonetheless, it will be critical to conduct research examining large and diverse

samples of participants, in addition to extensive research in real-world contexts featuring

fluctuation in ambient conditions, in order to further disentangle the relationship between TAC

and BAC. These future studies will also need to address the issue of potential “false positive”

TAC values produced by environmental alcohol, considering sensitivity and specificity as well

as the reliability of the Skyn over time and across devices. Relatedly, data from the current Skyn

prototype represents a raw value reflecting electrical current detected at the transdermal sensor

and has not been standardized to include a meaningful zero metric or reflect a scale comparable

to BAC. Thus, in the current study, we examine correlations between Skyn TAC and BAC,

rather than estimating the accuracy of measurements produced from the Skyn device. Skyn data

in the current study was standardized for each individual/device combination by subtracting out

the baseline value. Translating Skyn data into estimates along a standardized metric—and

accounting for factors that might lead to differential baseline values across different

device/individual combinations—is a task for future research.

Although the current study does suggest that the lag time between BAC and TAC

diminishes when TAC is measured using Skyn, the question of mechanism is unaddressed. The

extent to which this effect is explained by characteristics of the device (e.g., method of

measurement, sampling interval) or by the body positioning of the device (e.g., relative

distribution of sweat glands, permeability of skin) is left for future research to explore. It’s also

worth noting that the hand-assembled Skyn prototypes employed in this study yielded a

relatively high failure rate (18%-38% vs. 2% for SCRAM). More durable and reliable prototypes will likely be required before extensive field testing is feasible. Thus, at the current time,

SCRAM is still the most reliable transdermal alcohol sensor.

Finally, note that participants in the current study left the laboratory once their BrAC had

descended below .025% and their TAC had also begun to descend (see methods). Thus, although

these methods did capture the majority of BAC and TAC curves for participants enrolled, these

curves were not complete. Thus, analyses presented here that might be impacted by such

incomplete curves—area under the curve calculations and also cross correlation analyses—

should be interpreted with these truncated curves in mind. Future research should examine

complete TAC/BAC curves when feasible.

Conclusion

A wearable alcohol biosensor has the potential to fill a tremendous public health gap.

The path towards developing such a biosensor has been lengthy and involved formidable

challenges. Recent devices have been developed that leverage advances in miniaturization and

electronics, and rigorous research of such devices, employing multiple methods and large human

samples, offer the possibility of at last producing a viable alcohol biosensor and, importantly,

clarifying its potential place in the arsenal of techniques aimed at better researching, preventing,

and treating alcohol use disorders.

References

Anderson, J. C., & Hlastala, M. P. (2006). The kinetics of transdermal ethanol exchange. Journal

of Applied Physiology, 100(2), 649–655.

Barnett, N. P. (2015). Alcohol sensors and their potential for improving clinical care. Addiction,

110(1), 1–3.

Barnett, N. P., Tidey, J., Murphy, J. G., Swift, R., & Colby, S. M. (2011). Contingency

management for alcohol use reduction: A pilot study using a transdermal alcohol sensor.

Drug and Alcohol Dependence, 118(2), 391–399.

Barnett, N. P., Wei, J., & Czachowski, C. (2009). Measured alcohol content in college party

mixed drinks. Psychology of Addictive Behaviors, 23(1), 152–156.

Bendtsen, P., Hultberg, J., Carlsson, M., & Jones, A. W. (1999). Monitoring ethanol exposure in

a clinical setting by analysis of blood, breath, saliva, and urine. Alcoholism: Clinical and

Experimental Research, 23(9), 1446–1451.

Blincoe, L. J., Miller, T. R., Zaloshnja, E., & Lawrence, B. A. (2015). The Economic and

Societal Impact of Motor Vehicle Crashes, 2010.(Revised)(Report No. DOT HS 812

013). Washington, DC: National Highway Traffic Safety Administration.

Curtin, J. J., & Fairchild, B. A. (2003). Alcohol and cognitive control: Implications for regulation

of behavior during response conflict. Journal of Abnormal Psychology, 112(3), 424–556.

Davidson, D., Camara, P., & Swift, R. (1997). Behavioral effects and pharmacokinetics of low-

dose intravenous alcohol in humans. Alcoholism: Clinical and Experimental Research,

21(7), 1294–1299.

Davis, C. G., Thake, J., & Vilhena, N. (2010). Social desirability biases in self-reported alcohol

consumption and harms. Addictive Behaviors, 35(4), 302–311.

Dougherty, D. M., Charles, N. E., Acheson, A., John, S., Furr, R. M., & Hill-Kapturczak, N.

(2012). Comparing the detection of transdermal and breath alcohol concentrations during

periods of alcohol consumption ranging from moderate drinking to binge drinking.

Experimental and Clinical Psychopharmacology, 20(5), 373–381.

Fairbairn, C. E., Bresin, K. W., Kang, D., Rosen, I. G., Ariss, T., Luczak, S. E., … Eckland, N.

S. (2018). A multimodal investigation of contextual effects on alcohol’s emotional

rewards. Journal of Abnormal Psychology, 127(4), 359–373.

https://doi.org/10.1037/abn0000346

Fairbairn, C. E., & Kang, D. (in press). Transdermal alcohol monitors: Research, applications,

and future directions. In D. Frings & I. Albery (Eds.), The Handbook of Alcohol Use and

Abuse. Elsevier.

Fairbairn, C. E., Rosen, I. G., Luczak, S. E., & Venerable, W. J. (in press). Estimating the

quantity and time course of alcohol consumption from transdermal alcohol sensor data: A

combined laboratory-ambulatory study. Alcohol.

https://doi.org/10.1016/j.alcohol.2018.08.015

Fairbairn, C. E., Sayette, M. A., Wright, A. G. C., Levine, J. M., Cohn, J. F., & Creswell, K. G.

(2015). Extraversion and the rewarding effects of alcohol in a social context. Journal of

Abnormal Psychology, 124(3), 660–673. https://doi.org/10.1037/abn0000024

Fritsch, F. N., & Carlson, R. E. (1980). Monotone piecewise cubic interpolation. SIAM Journal

on Numerical Analysis, 17(2), 238–246.

George, W. H., Gournic, S. J., & McAfee, M. P. (1988). Perceptions of Postdrinking Female

Sexuality: Effects of gender, beverage choice, and drink payment. Journal of Applied

Social Psychology, 18(15), 1295–1316.

522 | Giles, H. G., Meggiorini, S., Renaud, G. E., Thiessen, J. J., Vidins, E. I., Compton, K. V., …
523 | Israel, Y. (1987). Ethanol vapor above skin: Determination by a gas sensor instrument
524 | and relationship with plasma concentration. Alcoholism: Clinical and Experimental
525 | Research, 11(3), 249–253.
526 | Gottman, J. M. (1981). Time-series analysis: A comprehensive introduction for social scientists.
527 | Cambridge: Cambridge University Press.
528 | Haynes, S. N., & Yoshioka, D. T. (2007). Clinical assessment applications of ambulatory
529 | biosensors. Psychological Assessment, 19(1), 44–57.
530 | Hill-Kapturczak, N., Lake, S. L., Roache, J. D., Cates, S. E., Liang, Y., & Dougherty, D. M.
531 | (2014). Do variable rates of alcohol drinking alter the ability to use transdermal alcohol
532 | monitors to estimate peak breath alcohol and total number of drinks? Alcoholism:
533 | Clinical and Experimental Research, 38(10), 2517–2522.
534 | Hill-Kapturczak, N., Roache, J. D., Liang, Y., Karns, T. E., Cates, S. E., & Dougherty, D. M.
535 | (2015). Accounting for sex-related differences in the estimation of breath alcohol
536 | concentrations using transdermal alcohol monitoring. Psychopharmacology, 232(1), 115–
537 | 123.
538 | Jones, A. W., & Andersson, L. (1996). Variability of the blood/breath alcohol ratio in drinking
539 | drivers. Journal of Forensic Science, 41(6), 916–921.
540 | Jones, A. W., & Andersson, L. (2003). Comparison of ethanol concentrations in venous blood
541 | and end-expired breath during a controlled drinking study. Forensic Science
542 | International, 132(1), 18–25.
543 | Kamei, T., Tsuda, T., Mibu, Y., Kitagawa, S., Wada, H., Naitoh, K., & Nakashima, K. (1998).
544 | Novel instrumentation for determination of ethanol concentrations in human perspiration

by gas chromatography and a good interrelationship between ethanol concentrations in

sweat and blood. Analytica Chimica Acta, 365(1–3), 259–266.

Kerr, W. C., Greenfield, T. K., Tujague, J., & Brown, S. E. (2005). A drink is a drink? Variation

in the amount of alcohol contained in beer, wine and spirits drinks in a US

methodological sample. Alcoholism: Clinical and Experimental Research, 29(11), 2015–

2021.

Kerr, W. C., Patterson, D., Koenen, M. A., & Greenfield, T. K. (2008). Alcohol content variation

of bar and restaurant drinks in Northern California. Alcoholism: Clinical and

Experimental Research, 32(9), 1623–1629.

Killick, R., Fearnhead, P., & Eckley, I. A. (2012). Optimal detection of changepoints with a

linear computational cost. Journal of the American Statistical Association, 107(500),

1590–1598.

Leffingwell, T. R., Cooney, N. J., Murphy, J. G., Luczak, S., Rosen, G., Dougherty, D. M., &

Barnett, N. P. (2013). Continuous objective monitoring of alcohol use: Twenty-first

century measurement using transdermal sensors. Alcoholism: Clinical and Experimental

Research, 37(1), 16–22. https://doi.org/10.1111/j.1530-0277.2012.01869.x

Luczak, S. E., & Rosen, I. G. (2014). Estimating BrAC from transdermal alcohol concentration

data using the BrAC estimator software program. Alcoholism: Clinical and Experimental

Research, 38(8), 2243–2252. https://doi.org/10.1111/acer.12478

Mandic, D. P., & Chambers, J. (2001). Recurrent neural networks for prediction: Learning

algorithms, architectures and stability. John Wiley & Sons, Inc.

Marques, P. R., & McKnight, A. S. (2009). Field and laboratory alcohol detection with 2 types of

transdermal devices. Alcoholism: Clinical and Experimental Research, 33(4), 703–711.

568 | National Advisory Council on Alcohol Abuse and Alcoholism. (1989). Recommended Council
569 | Guidelines on Ethyl Alcohol Administration on Human Experimentation.
570 | Organization, W. H. (2014). Global status report on alcohol and health 2014. Geneva,
571 | Switzerland: World Health Organization.
572 | Phillips, M. (1984). Sweat-patch testing detects inaccurate self-reports of alcohol consumption.
573 | Alcoholism: Clinical and Experimental Research, 8(1), 51–53.
574 | Ramchandani, V. A., Plawecki, M., Li, T.-K., & O’Connor, S. (2009). Intravenous ethanol
575 | infusions can mimic the time course of breath alcohol concentrations following oral
576 | alcohol administration in healthy volunteers. Alcoholism, Clinical and Experimental
577 | Research, 33(5), 938–944. https://doi.org/10.1111/j.1530-0277.2009.00906.x
578 | Sakai, J. T., Mikulich-Gilbertson, S. K., Long, R. J., & Crowley, T. J. (2006). Validity of
579 | Transdermal Alcohol Monitoring: Fixed and self-regulated dosing. Alcoholism: Clinical
580 | and Experimental Research, 30(1), 26–33.
581 | Sidek, K. A., & Khalil, I. (2013). Enhancement of low sampling frequency recordings for ECG
582 | biometric matching using interpolation. Computer Methods and Programs in
583 | Biomedicine, 109(1), 13–25.
584 | Sirlanci, M., Rosen, I. G., Luczak, S. E., Fairbairn, C. E., Bresin, K., & Kang, D. (2018).
585 | Deconvolving the input to random abstract parabolic systems: A population model-based
586 | approach to estimating blood/breath alcohol concentration from transdermal alcohol
587 | biosensor data. Inverse Problems, 34(12), 125006.
588 | Substance Abuse and Mental Health Services Administration. (2015). National Survey on Drug
589 | Use and Health: Summary of National Findings.

Swift, R. M. (2000). Transdermal alcohol measurement for estimation of blood alcohol

concentration. Alcoholism: Clinical and Experimental Research, 24(4), 422–423.

Swift, R. M. (2003). Direct measurement of alcohol and its metabolites. Addiction, 98(s2), 73–

80.

Swift, R. M., Martin, C. S., Swette, L., Laconti, A., & Kackley, N. (1992). Studies on a

wearable, electronic, transdermal alcohol sensor. Alcoholism: Clinical and Experimental

Research, 16(4), 721–725.

Swift, R. M., & Swette, L. (1992). Assessment of ethanol consumption with a wearable,

electronic ethanol sensor/recorder. In R. Z. Litten & J. P. Allen (Eds.), Measuring alcohol

consumption: Psychosocial and biochemical methods. (pp. 189–202). Totowa, NJ:

Humana Press.

Wang, Y., Fridberg, D. J., Leeman, R. F., Cook, R. L., & Porges, E. C. (in press). Wrist-worn

alcohol biosensors: Strengths, limitations, and future directions. Alcohol.

Watson, P. E., Watson, I. D., & Batt, R. D. (1981). Prediction of blood alcohol concentrations in

human subjects. Updating the Widmark Equation. Journal of Studies on Alcohol, 42(7),

547–556.

Weissenborn, R., & Duka, T. A. (2003). Acute alcohol effects on cognitive function in social

drinkers: Their relationship to drinking habits. Psychopharmacology, 165(3), 306–312.

White, A. M. (2003). What happened? Alcohol, memory blackouts, and the brain. Alcohol

Research and Health, 27(2), 186–196.

Zapolski, T. C. B., Pedersen, S. L., McCarthy, D. M., & Smith, G. T. (2014). Less drinking, yet

more problems: Understanding African American drinking and related problems.

Psychological Bulletin, 140(1), 188–223.

613

Table 1.
Studies examining validity of transdermal alcohol sensors using objective assessment techniques (BrAC/BAC)
Study | N | Type | Device | Locat | Alc Meas
Lag
(min)

r’s

Giles et al., 1987 | 19 | Lab | Unspec | Palm | BAC | NR | .94-.99
Swift & Swette, 1992 | 15 | Lab | WrisTAS | Arm | BrAC 30 | .61-.96
Davidson, Camara, & Swift, 1997 12 | Lab | Unspec | Arm | BrAC
| | | | | /BAC | NR | .52-.70
Dougherty et al., 2012 | 22 | Lab | SCRAM | Ankle | BrAC NR | .70-.99
Hill-Kapturczak et al., 2014 | 19 | Lab | SCRAM | Ankle | BrAC NR | NR
Hill-Kapturczak et al., 2015 | 21 | Lab | SCRAM | Ankle | BrAC 129 | .87
Wang, Fridberg, Leeman, Cook, & Porges, 2018 | 2 | Lab | Skyn /Tally | Wrist | BrAC 75 /55 | NR
Sakai et al., 2006 | 20 | Lab | SCRAM | Ankle | BrAC 150 | .49-.84
Fairbairn et al., 2018, in press | 48 | Lab/Amb | SCRAM | Ankle | BrAC 130 | NR
Marques & McKnight, 2009 | 22 | Lab/Amb | WrisTAS/ SCRAM | Wrist/ Ankle | BrAC 137/
| | | | | 270 | NR
Sakai et al., 2006 | 24 | Amb | SCRAM | Ankle | BrAC NR | NR
Luczak & Rosen, 2014 | 1 | Lab/Amb | WrisTAS | Wrist | BrAC NR | NR

The top section of this table lists studies conducted only in the laboratory, whereas the bottom section lists studies that included an ambulatory (field) assessment arm. Where a study contained both laboratory and ambulatory arms, but examined distinct groups of participants within these arms (e.g., Sakai et al., 2006), the study is listed under both sections of the table.

Note that, in the case of some of the studies listed above, data from the same sample were included in more than one publication (e.g., Fairbairn et al., 2018, in press). In such cases, only the citation for the parent (first) publication is listed in the table. Studies featuring devices that were not clearly “wearable” (e.g., Kamei et al., 1998) and also studies featuring sweat patches (e.g., Phillips, 1984) are not included.

Lab=laboratory study; Amb=Ambulatory study; Unspec =transdermal device not named; Locat=Body position of the transdermal device; Alc Meas=How BAC was measured in the study; BAC=Direct measure of BAC via blood or plasma; BrAC=Breathalyzer; Lag=time (in minutes) between peak BAC and peak TAC; NR=Not reported; r’s=correlation coefficients between TAC and BAC

614
Table 2.
Latency to Transdermal Detection of Alcohol Mean Minutes
(SD)

Paired t-test
(Skyn vs. SCRAM)
Latency to First Detection
SCRAM TAC | 22.52 (13.03)
Skyn TAC | 22.08 (12.38) | t(24)=.14, p=.891

Latency to Peak
BrAC | 77.28 (30.34)
SCRAM TAC | 197.20 (42.60)
Skyn TAC | 131.52 (32.90) | t(24)=6.41, p<.001

Max Cross-Correlation Lag
BrAC and SCRAM TAC | 68.56 (36.83)
BrAC and Skyn TAC | 23.88 (26.11) | t(24)=5.18, p<.001

SD=Standard deviation. TAC=Transdermal alcohol concentration. BrAC=Breath alcohol concentration.

All latency values above are calculated with respect to the beginning of the drink period for alcohol participants (N=25). Cross-correlations were calculated based on data collected from the beginning of the drink period until discharge, which occurred once BrAC had dropped below .025% and TAC had also begun to descend (average BrAC at discharge .019%)

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
Table 3.
Device-Level Maximal Cross-Correlation Values and Lag Times between BrAC and TAC

Device-Level Cross-Correlations for Skyn
Device ID | N | Mean Max Cross-
| | Correlation (SD) | Mean Max Cross-
| | | Correlation Lag (SD)
7AB3 | 8 | .66 (.16) | 17.75 (10.98)
B6B3 | 2 | .40 (.18) | 32.50 (7.78)
18 | 3 | .58 (.03) | 22.00 (14.18)
9 | 2 | .50 (.26) | 16.50 (23.34)
0DB5 | 10 | .62 (.12) | 29.10 (38.98)

Device-Level Cross-Correlations for SCRAM
24141 | 2 | 0.50 (0.05) | 26 (31.11)
80002 | 1 | 0.42 | 57
114798 | 2 | 0.47 (0.01) | 72 (11.31)
114888 | 4 | 0.43 (0.08) | 67 (25.81)
115307 | 4 | 0.53 (0.16) | 64.50 (24.37)
115411 | 1 | 0.69 | 48
115503 | 1 | 0.52 | 180
115887 | 1 | 0.57 | 93
117117 | 1 | 0.56 | 71
126571 | 1 | 0.61 | 118
127392 | 4 | 0.52 (0.21) | 48.75 (33.08)
127453 | 1 | 0.50 | 49
127773 | 2 | 0.51 (0.06) | 90.50 (41.72)
SD=Standard deviation. TAC=Transdermal alcohol concentration. BrAC=Breath alcohol concentration. N=Number of participants who wore this device. Mean Max Cross-Correlation Lag is presented in minutes. Devices worn by only one participant list no standard deviation.

Cross-correlations refer to within-subject correlations between TAC (measured either using Skyn or SCRAM devices) and BrAC for alcohol participants (N=25) measured over time during the course of the lab session. Cross-correlations were calculated based on data collected from the beginning of the drink period until discharge, which occurred once BrAC had dropped below .025% and TAC had also begun to descend (average BrAC at discharge .019%). Cross-correlations listed under Skyn devices represent associations between BrAC and Skyn-measured TAC, and cross-correlations listed under SCRAM devices represent associations between BrAC and SCRAM-measured TAC.

Of the Skyn devices listed above, 7AB3, B6B3, and 0DB5 represent older generation Skyn prototypes (2016), whereas devices 18 and 9 represent newer generation prototypes (2018). 637
638

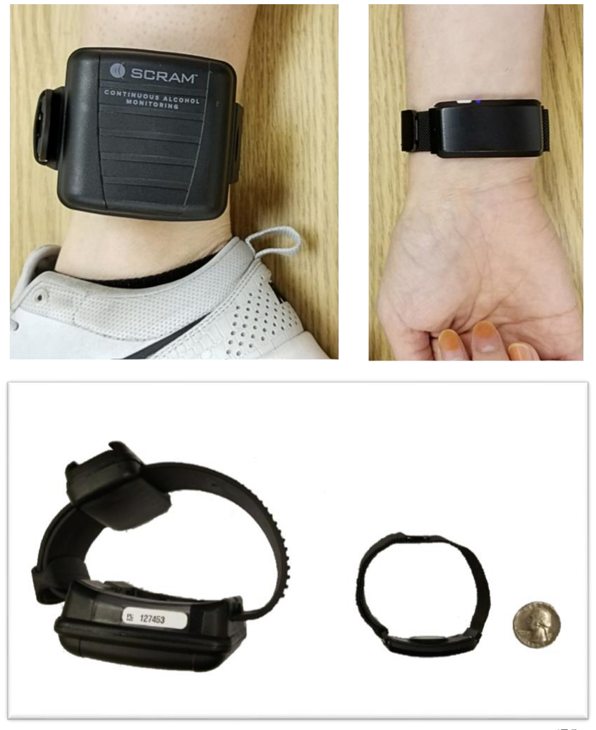
[picture p45: figure]

675
676
677
678
679
680

Figure 1. AMS SCRAM ankle bracelet (left) and BACtrack Skyn wrist monitor (right) displayed side-by side. The top panel displays these devices as worn on ankle/wrist, whereas the bottom panel displays them to scale. The approximate weight of the devices is 6oz (SCRAM) and 1oz (Skyn prototype), respectively.

683
684
685
686

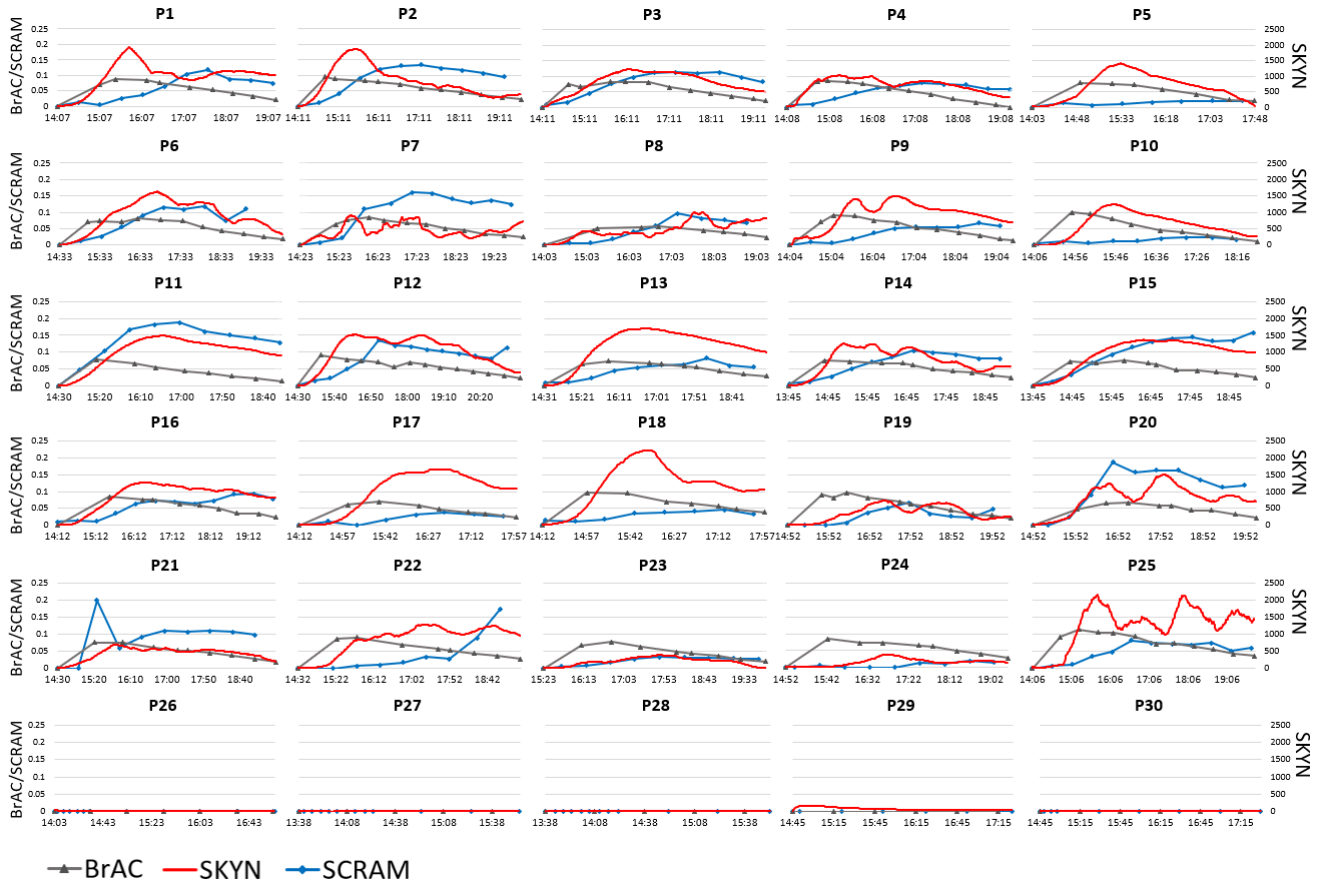
[picture p46: figure]

Figure 2. Skyn prototype, SCRAM, and BrAC data for each of the 25 participants assigned to receive alcohol (P1-P25) as well as the 5 no-alcohol control participants (P26-P30). Data reflects the entire period of assessment, beginning from the moment just prior to first alcohol consumption (beginning of the drink period) to the final BrAC reading. For this visualization of Skyn data, data was standardized by subtracting the lowest value for each participant file, and a 30-minute moving average window was also applied.
