ryanjhermes/Wearable/pcb/fabrication/jlcpcb_standard_pcba/assembly/bottom_assembly.pdf

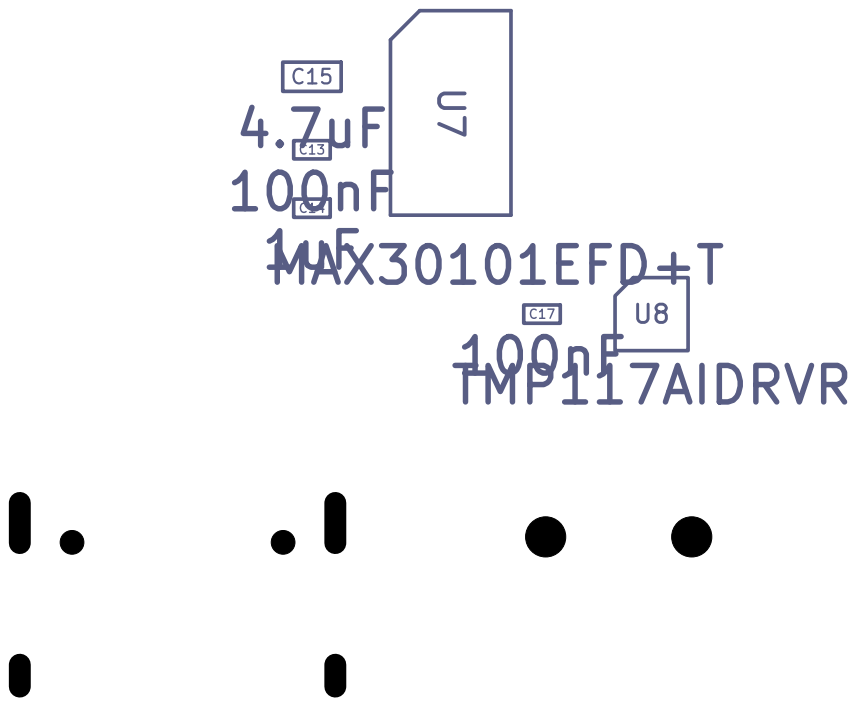
[picture p47: page 1]
