ryanjhermes/Wearable/pcb/fabrication/jlcpcb_standard_pcba/assembly/top_assembly.pdf

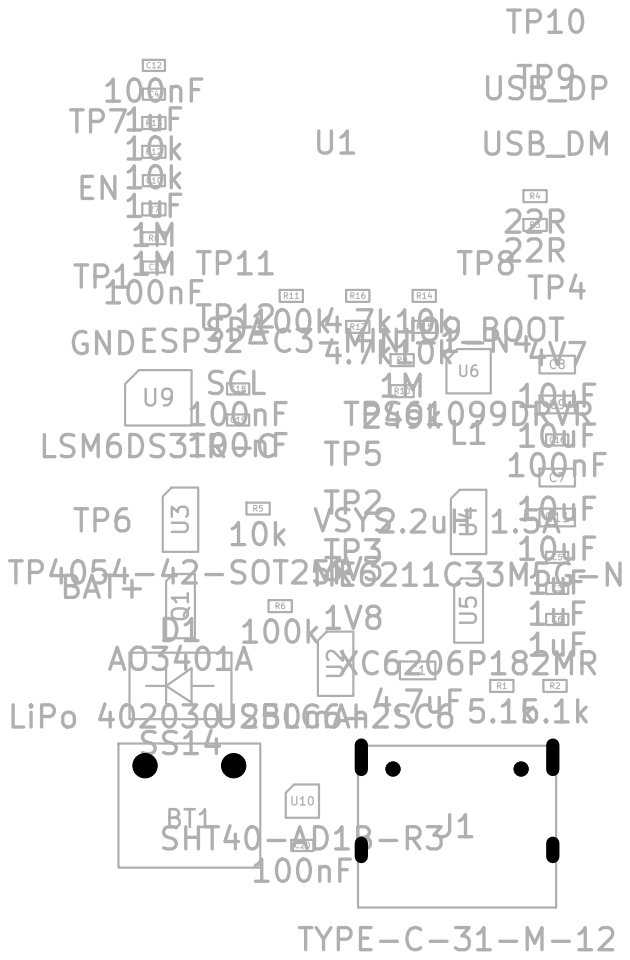
[picture p48: page 1]
