ryanjhermes/Wearable/pcb/wearable_v2.kicad_pcb

## KiCad design pcb/wearable_v2.kicad_pcb (2026-09-18)

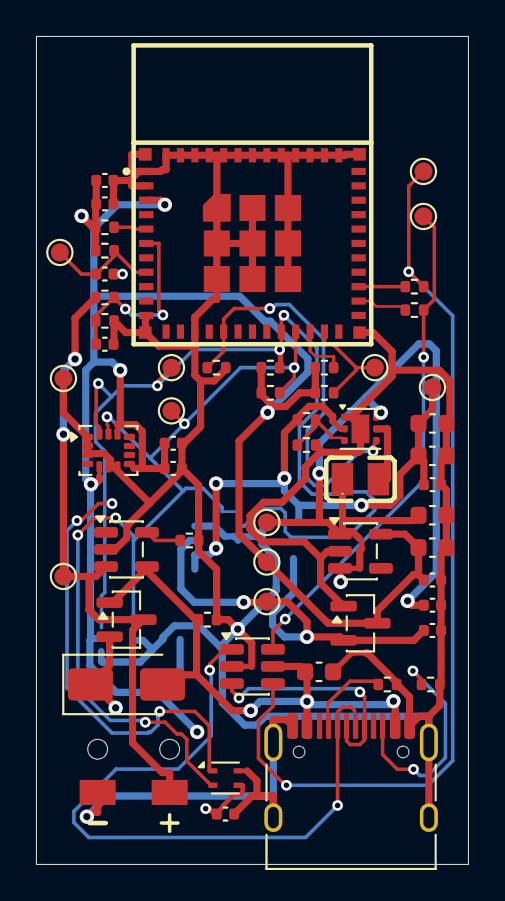
[picture p49: board wearable_v2.kicad_pcb from above]

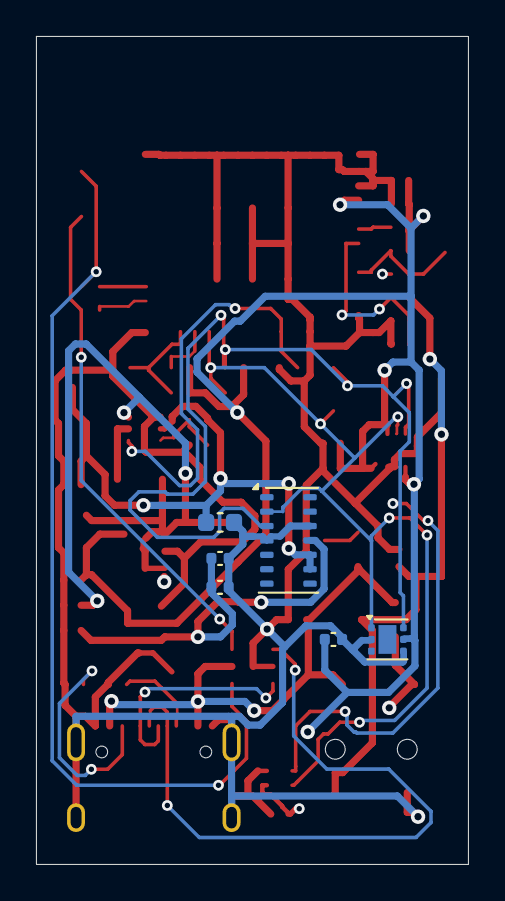
[picture p50: board wearable_v2.kicad_pcb from below]

Board: 4 copper layers, 24.0 x 46.0 mm, 64 parts (6 on the bottom side), 26 nets.

Parts:
BT1: LiPo 402030 250mAh; BatteryPads_2x
C1, C15: 4.7uF; C_0603_1608Metric
C2, C12, C13, C16, C17, C18, C19, C20: 100nF; C_0402_1005Metric
C3, C4, C5, C6, C10, C14: 1uF; C_0402_1005Metric
C7, C8, C9, C11: 10uF; C_0603_1608Metric
D1: SS14; D_SMA
J1: TYPE-C-31-M-12; USB_C_Receptacle_HRO_TYPE-C-31-M-12
L1: 2.2uH 1.5A; L_MAKK2016T_2.0x1.6mm
Q1: AO3401A; SOT-23
R1, R2: 5.1k; R_0402_1005Metric
R3, R4: 22R; R_0402_1005Metric
R5, R12, R13, R14, R15: 10k; R_0402_1005Metric
R6, R11: 100k; R_0402_1005Metric
R7, R8, R9: 1M; R_0402_1005Metric
R10: 249k; R_0402_1005Metric
R16, R17: 4.7k; R_0402_1005Metric
TP1: GND; TestPoint_Pad_D1.0mm
TP2: 3V3; TestPoint_Pad_D1.0mm
TP3: 1V8; TestPoint_Pad_D1.0mm
TP4: 4V7; TestPoint_Pad_D1.0mm
TP5: VSYS; TestPoint_Pad_D1.0mm
TP6: BAT+; TestPoint_Pad_D1.0mm
TP7: EN; TestPoint_Pad_D1.0mm
TP8: IO9_BOOT; TestPoint_Pad_D1.0mm
TP9: USB_DM; TestPoint_Pad_D1.0mm
TP10: USB_DP; TestPoint_Pad_D1.0mm
TP11: SDA; TestPoint_Pad_D1.0mm
TP12: SCL; TestPoint_Pad_D1.0mm
U1: ESP32-C3-MINI-1-N4; ESP32-C3-MINI-1
U2: USBLC6-2SC6; SOT-23-6
U3: TP4054-42-SOT25R; SOT-23-5
U4: ME6211C33M5G-N; SOT-23-5
U5: XC6206P182MR; SOT-23
U6: TPS61099DRVR; WSON-6-1EP_2x2mm_P0.65mm_EP1x1.6mm
U7: MAX30101EFD+T; Maxim_OLGA-14_3.3x5.6mm_P0.8mm
U8: TMP117AIDRVR; WSON-6-1EP_2x2mm_P0.65mm_EP1x1.6mm
U9: LSM6DS3TR-C; LGA-14_3x2.5mm_P0.5mm_LayoutBorder3x4y
U10: SHT40-AD1B-R3; Sensirion_DFN-4_1.5x1.5mm_P0.8mm_SHT4x_NoCentralPad

Connections:
1V8: C6.1, C13.1, C14.1, TP3.1 (1_1), U5.2 (VO), U7.11 (VDD)
3V3: C4.1, C5.1, C11.1, C12.1, C17.1, C18.1, C19.1, C20.1, R12.1, R13.1, R14.1, R15.1, R16.1, R17.1, TP2.1 (1_1), U1.3 (3V3), U4.5 (V_{OUT}), U5.3 (VI), U8.5 (V+), U9.5 (VDDIO), U9.8 (VDD), U9.12 (CS), U10.3 (VDD)
4V7: C8.1, C9.1, C15.1, C16.1, R9.1, TP4.1 (1_1), U6.2 (VOUT), U7.9 (VLED+), U7.10 (VLED+)
/BAT_SENSE: C2.1, R7.2, R8.1, U1.6 (IO3)
/CC1: J1.A5 (CC1), R1.1
/CC2: J1.B5 (CC2), R2.1
/EN: C10.1, R12.2, TP7.1 (1_1), U1.8 (EN)
/FB_PPG: R9.2, R10.1, U6.3 (FB)
/IO2_STRAP: R13.2, U1.5 (IO2)
/IO8_STRAP: R14.2, U1.22 (IO8)
/IO9_BOOT: R15.2, TP8.1 (1_1), U1.23 (IO9)
/IO18_USB_DM: R3.1, U1.26 (IO18)
/IO19_USB_DP: R4.1, U1.27 (IO19)
/PPG_PWR_EN: R11.1, U1.16 (IO10), U6.4 (EN)
/PROG: R5.1, U3.5 (PROG)
/SCL: R17.2, TP12.1 (1_1), U1.21 (IO7), U7.2 (SCL), U8.1 (SCL), U9.13 (SCL), U10.2 (SCL)
/SDA: R16.2, TP11.1 (1_1), U1.20 (IO6), U7.3 (SDA), U8.6 (SDA), U9.14 (SDA), U10.1 (SDA)
/SW_PPG: L1.2, U6.5 (SW)
/USB_DM: R3.2, TP9.1 (1_1), U2.6 (I/O1)
/USB_DM_CON: J1.A7 (D-), J1.B7 (D-), U2.1 (I/O1)
/USB_DP: R4.2, TP10.1 (1_1), U2.4 (I/O2)
/USB_DP_CON: J1.A6 (D+), J1.B6 (D+), U2.3 (I/O2)
BAT+: BT1.1 (+), Q1.3 (D), R7.1, TP6.1 (1_1), U3.3 (BAT)
GND: BT1.2 (-), C1.2, C2.2, C3.2, C4.2, C5.2, C6.2, C7.2, C8.2, C9.2, C10.2, C11.2, C12.2, C13.2, C14.2, C15.2, C16.2, C17.2, C18.2, C19.2, C20.2, J1.A1 (GND), J1.A12 (GND), J1.B1 (GND), J1.B12 (GND), J1.SH (SHIELD), R1.2, R2.2, R5.2, R6.2, R8.2, R10.2, R11.2, TP1.1 (1_1), U1.1 (GND), U1.2 (GND), U1.11 (GND), U1.14 (GND), U1.36 (GND), U1.37 (GND), U1.38 (GND), U1.39 (GND), U1.40 (GND), U1.41 (GND), U1.42 (GND), U1.43 (GND), U1.44 (GND), U1.45 (GND), U1.46 (GND), U1.47 (GND), U1.48 (GND), U1.49 (GND), U1.50 (GND), U1.51 (GND), U1.52 (GND), U1.53 (GND), U2.2 (GND), U3.2 (GND), U4.2 (V_{SS}), U5.1 (GND), U6.1 (GND), U6.7 (GND), U7.4 (PGND), U7.12 (GND), U8.2 (GND), U8.4 (ADD0), U9.1 (SDO/SA0), U9.2 (SDX), U9.3 (SCX), U9.6 (GND), U9.7 (GND), U10.4 (VSS)
VBUS: C1.1, D1.2 (A), J1.A4 (VBUS), J1.A9 (VBUS), J1.B4 (VBUS), J1.B9 (VBUS), Q1.1 (G), R6.1, U2.5 (VBUS), U3.4 (VCC)
VSYS: C3.1, C7.1, D1.1 (K), L1.1, Q1.2 (S), TP5.1 (1_1), U4.1 (V_{IN}), U4.3 (CE), U6.6 (VIN)
