ryanjhermes/Wearable/(commit log)

2026-06-21 Remove outdated documentation and add new structured files for development setup, project plan, hardware list, wiring guide, and .gitignore. This update streamlines the project resources for the wear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
2026-07-13 Add working MAX30102 heart-rate firmware
    Phase 3 heart rate confirmed working: soldered MAX30102 detected at
    0x57, live PPG via SparkFun MAX3010x lib, checkForBeat detection with
    4-beat averaging. Output throttled to one summary line per second.
    Avg BPM holds steady ~75-80 with a still fingertip.
    Also fixes serial port typo in CLAUDE.md (usbmodem101 -> usbmodem1101)
    and adds a repo-layout/docs-pointer section.
    [main.cpp]
2026-07-13 Add MLX90614 temperature read via direct Wire register calls
    MLX90614 confirmed at 0x5A post-solder. Reads ambient (0x06) and
    object (0x07) temperature over SMBus with no third-party library
    (Adafruit lib won't build here). Object temp tracks the aimed target;
    verified against skin (~35C), soldering iron (>100C), and room (~26C).
    [main.cpp]
2026-07-14 Lots of stuff- accelerometer working, but temperature sensor broke (overheated? fried out?)
    [main.cpp]
2026-07-20 Enhance CLAUDE.md with exploratory application details for EDA sensor and hardware constraints. Update platformio.ini to include battery power-check environment. Document successful battery wiring te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
2026-07-24 Add various projects for MAX30102 heart rate sensor and MLX90614 temperature sensor
    - Implement combined heart rate and temperature monitoring in `combined_hr_temp/main.cpp`
    - Create I2C scanner for detecting devices in `i2c_scanner/main.cpp`
    - Develop heart rate monitoring using MAX30102 in `max30102_heartrate/main.cpp`
    - Add BLE streaming capabilities for heart rate data in `max30102_hr_ble/main.cpp`
    - Implement logging functionality for heart rate data in `max30102_hr_log/main.cpp`
    - Directly read temperature from MLX90614 in `mlx90614_temperature/main.cpp`
    - Create a store-and-forward logging system with BLE streaming in `max30102_hr_ble_log/main.cpp`
    [enclosure_bottom.3mf, enclosure_top.3mf]
2026-07-26 Add hardware debug log for board thermal fault and excessive current draw
    - Documented a board thermal fault observed on the XIAO module during USB charging, detailing symptoms, diagnosis, and recommendations for replacement.
    - Updated CLAUDE.md to include potential board switch to XIAO ESP32-C3 for improved power efficiency and runtime.
    - Added new environment configuration for max30102_raw_ir in platformio.ini to support raw IR waveform capture.
    - Enhanced ble_hr_stream.py to include reading timestamps for BLE data, allowing for accurate sample timing.
    - Modified main.cpp in max30102_hr_ble_log to adjust CPU frequency and BLE TX power settings for reduced heat generation.
    - Introduced new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
    [main.cpp]
2026-09-12 Trying PCB Stuff
    [Wearable_Carrier_V1.kicad_pcb, Wearable_Carrier_V1.kicad_sch, enclosure_bottom.3mf, enclosure_top.3mf]
2026-09-16 Lots of stuff:
    - new parts for fab pcb in v2, ios scaffolding
    - moved old stuff to archive/v1
    [Wearable_Carrier_V1.kicad_pcb, Wearable_Carrier_V1.kicad_sch]
2026-09-16 ^ same as last commit
    [ble_hr_20260719_215245.csv, ble_hr_20260719_215525.csv, ble_hr_20260722_212249.csv, ble_hr_20260722_212316.csv, ble_hr_20260722_220720.csv, ble_hr_20260722_221049.csv, ble_hr_20260722_221519.csv, ble_hr_20260723_210937.csv]
2026-09-16 Add SS14 Schottky diode and TPS61099 boost converter documentation
    - Created README.md for SS14 with specifications and connection details.
    - Added datasheet for SS14.
    - Created README.md for TPS61099 with specifications, pinout, and required external components.
    - Added datasheet for TPS61099.
2026-09-16 Update documentation for V2 schematic and component decisions, including GPIO10 control for TPS61099 and capture approval status.
2026-09-16 Add the three missing PCB footprints and verify them against datasheets
    Completes step 1 of the schematic-to-PCB path. Every symbol in
    wearable_v2.kicad_sch now resolves to a footprint; ERC drops from 5
    warnings to 2 (both benign LSM6DS3TR-C strap warnings).
    - ESP32-C3-MINI-1 and MAKK2016T2R2M imported from LCSC via easyeda2kicad,
    which also carries the JLCPCB assembly rotation a hand-drawn footprint
    would not.
    - BatteryPads_2x hand-authored: two solder pads plus two NPTH strain-relief
    holes, excluded from BOM and pick-and-place.
    - STEP models copied into pcb_v2.3dshapes and paths repointed at KIPRJMOD,
    since the imports referenced a scratch directory that will vanish.
    Verification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
    [bom_from_schematic.csv, wearable_v2.kicad_sch]
2026-09-16 Correct two stale claims in the pcb_v2 README
    The status line still said 5 ERC warnings, and the "no footprint audit"
    item read as if nothing had been checked. Two of 51 footprints are now
    verified; the other 48 are still package-name matches, and that is the
    distinction the item needs to make.
2026-09-16 Rename pcb_v2/ to pcb/ and confirm the inductor's ratings with the vendor
    Folder, footprint library nickname, 3D-model directory and every reference
    across CLAUDE.md, parts/ and the project files now use "pcb". The KiCad
    project files keep the wearable_v2 name: that "v2" identifies the board
    revision, not the folder scheme, and renaming it would mean rewriting the
    project name embedded in every symbol instance path.
    Note for anyone reading history: an unrelated abandoned pcb/ folder was
    deleted on 2026-09-14 (recoverable at ebf99dc), so `git log -- pcb/` spans
    two different things.
    MAKK2016T2R2M ratings are now manufacturer-confirmed rather than taken from
    a distributor listing: 2.2uH +/-2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
    [bom_from_schematic.csv, wearable_v2.kicad_sch]
2026-09-16 Correct a stale fp-lib-table description left over from before the footprints existed
2026-09-17 working on pcb, got a kicad plugin
    [wearable_v2.kicad_pcb, wearable_v2.kicad_sch]
2026-09-17 schematic update
    [wearable_v2.kicad_sch]
2026-09-18 orchestrator/subagent architecture, BACtrack comp analysis
    [wearable_v2.kicad_pcb]
2026-09-18 Checkpoint: R10 249k, battery closed, docs reflect verified state
    Design change (user-approved):
    - R10 270k -> 249k (0402WGF2493TCE / C11425) in schematic and PCB. Value,
    MPN and LCSC only; netlist untouched. Moves the 4V7 worst-case low corner
    from 4.470 V to 4.770 V against the MAX30101's 4.5 V green VLED+ minimum.
    - KiCad F8 deliberately not run; property fields patched directly to avoid
    the documented KiCad 10.0.5 stale-U4-pad hazard.
    - Re-verified: ERC 2 known warnings, DRC 5 known-acceptable / 0 unconnected,
    parity 0 issues, analyze_pcb.py 51 findings (2/18/31) — all identical to
    the accepted 2026-09-17 baseline.
    - Fabrication package regenerated and revalidated 15/15 PASS.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
    [battery_wire_keepout.step, bom_from_schematic.csv, enclosure_bottom.step, enclosure_bottom.stl, enclosure_top.step, enclosure_top.stl, jlcpcb_bom.csv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]
2026-09-18 enclosure update too
    [battery_wire_keepout.step, enclosure_bottom.step, enclosure_bottom.stl, enclosure_top.step, enclosure_top.stl, max30101_opaque_gasket.step, mechanical_fit_assembly.step, selected_battery_envelope.step]
